veda-Anomap/Edgedevice_stm32/VERSION_HISTORY.md

# Version History

프로젝트 변경 이력을 시간 순서대로 기록합니다.
각 항목은 아래 형식으로 정리합니다.

- 변경 전 문제
- 변경 이유
- 구현 방식
- 변경 후 효과

---

## [v1.2.14] - 2026-03-25
### TDOA 9단계: FFT/IFFT 기반 GCC-PHAT 전환 + 게이트 경로 분리

변경 전 상태/문제
- TDOA Stage-3 경로가 128-point 직접 DFT + lag별 상관 직접합산(`O(N^2)`) 구조라, 연산량이 크고 주기 부하가 높았음.
- I2S 입력에서 하드 노이즈 게이트(`|x|<TH => 0`)를 TDOA 입력에도 동일 적용해, 위상 기반 상관에서 불연속 아티팩트가 생길 여지가 있었음.

왜 바꿨는지
- TDOA 추정의 핵심 연산을 더 가볍고 안정적인 주파수 도메인 파이프라인으로 바꿔 실시간 여유를 확보하기 위함.
- 레벨 기반 방향검출(`detect_dir`)에 필요한 게이트는 유지하되, GCC-PHAT 위상 경로는 원 신호를 보존해 피크 왜곡을 줄이기 위함.

무엇을 어떻게 바꿨는지
- `Core/Src/mic.c`
  - 직접 DFT/lag합산 함수를 제거하고, `radix-2 FFT/IFFT (128)` 기반 함수 추가:
    - `tdoa_fft_c128_inplace()`
    - `tdoa_fft_real_windowed_128()`
    - `tdoa_ifft_phat_to_corr_abs()`
  - Stage-3 계산 흐름 변경:
    - `FFT(X1), FFT(X2)` -> `G = X1*conj(X2)` -> `PHAT normalize` -> `IFFT` -> lag 구간 피크 탐색
  - I2S 샘플 처리 경로 분리:
    - `l16/r16`(게이트 적용) -> 기존 레벨/방향검출 경로(`mic_process_interleaved_u16`)
    - `l16_tdoa/r16_tdoa`(ungated) -> TDOA half-block 누적 버퍼
  - TDOA 버퍼 저장값은 ungated 샘플 사용하도록 변경.
- `README.md`
  - TDOA 9단계(FFT/IFFT 전환 + 게이트 분리) 반영.
  - TDOA 동작 주의사항에 `O(N log N)` 전환/게이트 분리 정책 추가.

변경 후 기능/안정성 개선 효과
- TDOA 핵심 연산 복잡도가 `O(N^2)`에서 `O(N log N)`로 낮아져 주기 부하가 완화됨.
- 위상 경로 신호 보존으로 GCC-PHAT 피크 품질 저하 가능성이 줄어듦.
- `detect_dir` 경로의 노이즈 억제 특성은 유지하면서 TDOA 추정 신뢰도 개선 여지 확보.

영향 파일
- `Core/Src/mic.c`
- `README.md`
- `VERSION_HISTORY.md`

---

## [v1.2.13] - 2026-03-20
### TDOA 8단계: 연산 주기 제한 + 모드 기반 스케줄링 최적화

변경 전 상태/문제
- TDOA(GCC-PHAT) 경로가 ControlTask 주기마다 실행되어, AUTO/수동 여부와 관계없이 CPU를 지속 점유했음.
- 수동 제어 중에도 불필요한 TDOA 연산이 돌아 UART/명령 응답성에 부담을 줄 수 있었음.
- TDOA 결과가 오래 갱신되지 않아도 `valid` 상태가 잠시 남을 수 있었음.

왜 바꿨는지
- 실시간 제어에서 “필요할 때만 무거운 연산을 수행”하도록 스케줄링을 최적화해 전체 시스템 여유를 확보하기 위함.
- MANUAL 우선 구간에서는 입력/제어 응답성을 높이고, AUTO에서는 안정된 주기로 TDOA를 유지하기 위함.

무엇을 어떻게 바꿨는지
- `Core/Src/mic.c`
  - TDOA 주기 제한 상수 추가:
    - `TDOA_PROCESS_PERIOD_MS=20`
    - `TDOA_STALE_INVALID_MS=300`
  - 런타임 상태 추가:
    - `tdoa_last_proc_ms`, `tdoa_last_result_ms`
  - `mic_tdoa_process(now)`에서 20ms 미만 호출은 heavy 연산을 스킵하도록 변경.
  - 결과 갱신이 오래 없으면 `valid`를 자동 해제(stale invalidate).
  - `mic_tdoa_enable(0)` 시 관련 타임스탬프/상태 초기화.
- `Core/Src/app.c`
  - `app_control_loop()`에서 TDOA 처리를 `MODE_AUTO`일 때만 호출하도록 변경.

변경 후 기능/안정성 개선 효과
- ControlTask의 평균 CPU 점유 감소(특히 MANUAL 모드).
- 수동 조작/통신 처리 응답성 개선.
- 오래된 TDOA 결과의 잔존으로 인한 잘못된 신뢰 상태가 줄어듦.

영향 파일
- `Core/Src/mic.c`
- `Core/Src/app.c`
- `README.md`
- `VERSION_HISTORY.md`

---

## [v1.2.12] - 2026-03-20
### TDOA 7단계: 물리 lag 제한 + Hann 윈도우 적용

변경 전 상태/문제
- GCC-PHAT lag 탐색이 고정 범위(`±8`)라 실제 마이크 간격(120mm)에서 물리적으로 불가능한 지연까지 후보에 포함되어,
  반향/잡음 상황에서 가짜 피크를 선택할 여지가 있었음.
- 프레임 경계 불연속으로 인한 스펙트럼 누설이 피크 선명도를 떨어뜨릴 수 있었음.

왜 바꿨는지
- TDOA 추정을 실제 하드웨어 기하(마이크 간격, 음속, 샘플레이트)에 맞춘 유효 범위로 제한해 오탐을 줄이기 위함.
- PHAT 이전 스펙트럼 안정화를 통해 피크 분리를 개선하기 위함.

무엇을 어떻게 바꿨는지
- `Core/Src/mic.c`
  - `tdoa_effective_lag_max()` 추가:
    - `lag_max = round(fs*d/c) + margin` 계산 후 `TDOA_LAG_MAX`로 clamp
    - lag 스캔/보간 경계를 동적으로 `±lag_max`로 사용
  - Hann window 추가:
    - `tdoa_prepare_hann()`로 128프레임 윈도우 1회 생성
    - `tdoa_dft_real_128()`에 window 인자 추가 후 DFT 입력에 적용
  - 리셋 시 Hann 준비 상태 초기화
- `Core/Src/app.c`
  - UART1 복구 함수 내 깨진 주석 정리(동작 변경 없음)

변경 후 기능/안정성 개선 효과
- 물리적으로 불가능한 lag 후보가 제거되어 반향 환경의 잘못된 방향 선택 확률 감소.
- 윈도우 적용으로 스펙트럼 누설이 줄어 피크 대조도가 개선되고 confidence 변동 완화.
- 기존 Stage 4~6(히스테리시스/EMA/추종기)와 결합 시 방향 추종 안정성 추가 향상.

영향 파일
- `Core/Src/mic.c`
- `Core/Src/app.c`
- `VERSION_HISTORY.md`

---

## [v1.2.11] - 2026-03-20
### TDOA 6단계: PAN 추종기 가변 이득 + 가속도 제한

변경 전 상태/문제
- 5단계는 TDOA 각도 연동은 되었지만, PAN 추종 step이 사실상 고정에 가까워
  큰 오차 구간에서 느리고, 목표 근처에서는 미세 떨림 체감이 남을 수 있었음.
- 추종 속도 상태가 없어 프레임 간 오차 변화에 따른 자연스러운 가감속이 부족했음.

왜 바꿨는지
- 실제 팬틸트 동작에서 “멀 때 빠르게 / 가까우면 부드럽게” 동작하도록
  추종 프로파일을 제어기 형태로 개선하기 위함.

무엇을 어떻게 바꿨는지
- `Core/Src/motor_ctrl.c`
  - TDOA 추종 파라미터 추가:
    - `TDOA_STEP_MIN/MAX_PWM`
    - `TDOA_GAIN_Q8`
    - `TDOA_ACCEL_UP/DN_PWM`
    - `TDOA_DEADBAND_PWM`
  - 내부 속도 상태(`tdoa_track_speed_pwm`) 도입
  - `motor_ctrl_track_pan_tdoa()`를 가변 이득 + 가속도 제한 방식으로 변경:
    - 오차 기반 목표 step 계산
    - step 변화율 제한(accel/decel limit)
    - 목표점 근처 overshoot 방지(목표 교차 시 클램프)
  - 모드 전환/기존 detect_dir 제어 진입 시 추종 속도 상태 초기화

변경 후 기능/안정성 개선 효과
- 큰 각도 오차에서 추종 응답 속도 향상.
- 목표 근처에서 속도가 줄어 급한 튐/잔떨림 완화.
- AUTO fallback 경로(`SRC:D`)와 공존하면서 제어 전환 충격 감소.

영향 파일
- `Core/Src/motor_ctrl.c`
- `VERSION_HISTORY.md`

---

## [v1.2.10] - 2026-03-20
### TDOA 5단계: 각도 기반 PAN 추종 + 자동 fallback 연계

변경 전 상태/문제
- 4단계까지는 TDOA 각도 신호 품질을 안정화했지만, 실제 AUTO 모터 제어는 여전히 `L/R` 2값 중심으로 동작했음.
- TDOA `valid`가 존재해도 모터가 각도 연속 추종을 하지 않아, 세밀한 방향 제어 이점이 제한적이었음.

왜 바꿨는지
- TDOA 파이프라인 결과(`alpha_deg_x10`)를 실제 PAN 제어에 연결해
  좌/우 이진 제어에서 연속 각도 추종으로 확장하기 위함.
- TDOA 신호가 잠시 사라질 때는 기존 `detect_dir` 로직으로 자동 복귀해 안정성을 유지하기 위함.

무엇을 어떻게 바꿨는지
- `Core/Inc/motor_ctrl.h`
  - `motor_ctrl_track_pan_tdoa()` API 추가
- `Core/Src/motor_ctrl.c`
  - TDOA 각도(-90~+90도)를 PAN PWM 범위로 매핑하는 함수 추가
  - PAN 추종 시 step 제한(`TDOA_STEP_PWM`) + deadband(`TDOA_DEADBAND_PWM`) 적용
  - TDOA 추종 활성 중 기존 one-shot auto state(`pending_dir/motor_running/lock`) 비활성화
- `Core/Src/app.c`
  - AUTO 루프에서 TDOA 우선 제어 경로 추가:
    - `valid`면 TDOA 각도 추종
    - `valid` 소실 시 짧은 hold(`TDOA_FALLBACK_HOLD_MS`) 후 기존 `mic_process()+motor_ctrl_process()`로 fallback
  - 디버그 로그에 제어 소스 표기 `SRC:T/D/M` 추가

변경 후 기능/안정성 개선 효과
- AUTO 모드에서 TDOA 유효 시 PAN이 연속 각도 기반으로 부드럽게 추종.
- TDOA 신호 공백 시 기존 L/R 로직으로 자동 복귀해 동작 연속성 확보.
- 로그로 현재 제어 소스(`SRC`)를 즉시 확인 가능해 현장 디버깅 용이성 증가.

영향 파일
- `Core/Inc/motor_ctrl.h`
- `Core/Src/motor_ctrl.c`
- `Core/Src/app.c`
- `VERSION_HISTORY.md`

---

## [v1.2.9] - 2026-03-20
### TDOA 4단계: 히스테리시스 + hold + EMA + slew 제한

변경 전 상태/문제
- 3단계에서 `tau/angle` 계산은 가능해졌지만, 반향/잡음 환경에서 confidence가 경계값 근처를 오갈 때
  `valid`가 빠르게 깜빡이며 각도도 프레임 단위로 흔들릴 수 있었음.
- 모터 추종 전에 각도 신호를 한 번 더 안정화하지 않으면 미세 진동/방향 반전 체감이 커질 수 있었음.

왜 바꿨는지
- 실시간 운용에서 “신뢰도 경계 출렁임”을 줄이고, 연속 프레임의 각도 변화를 부드럽게 만들어
  제어 입력으로 쓰기 좋은 형태로 다듬기 위함.

무엇을 어떻게 바꿨는지
- `Core/Src/mic.c`
  - confidence 히스테리시스 추가:
    - ON 임계(`TDOA_CONF_ON_Q8`)
    - OFF 임계(`TDOA_CONF_OFF_Q8`)
  - 유효 신호 hold 시간(`TDOA_VALID_HOLD_MS`) 추가:
    - 순간적인 confidence 하락에도 짧은 구간은 `valid` 유지
  - 각도 안정화 필터 추가:
    - 프레임 간 최대 변화량 제한(`TDOA_MAX_STEP_DEG_X10`)
    - EMA(`TDOA_EMA_ALPHA_Q8`) 적용
    - 각도 clamp(`TDOA_ANGLE_CLAMP_DEG_X10`) 적용
  - 내부 상태 변수(`tdoa_track_valid`, `tdoa_last_good_ms`, `tdoa_ema_angle_x10`) 추가

변경 후 기능/안정성 개선 효과
- confidence 경계 구간에서 `valid` 깜빡임이 줄어듦.
- 각도 변화가 단계적으로 완만해져 추종 신호 품질 향상.
- 이후 모터 제어 연결 단계에서 진동/급반전 리스크 감소.

영향 파일
- `Core/Src/mic.c`
- `VERSION_HISTORY.md`

---

## [v1.2.8] - 2026-03-20
### TDOA 3단계: 경량 GCC-PHAT + 서브샘플 보간 + 각도 산출

변경 전 상태/문제
- 2단계는 VAD/오버랩/코스 lag까지만 있어, lag가 샘플 단위로만 나오고 미세 각도 분해능이 낮았음.
- 반향 환경에서 단순 상관만으로는 피크 분리가 약해 신뢰도 변동이 컸음.

왜 바꿨는지
- 1D 좌우 각도 제어를 목표로, TDOA를 샘플 정수 단위에서 서브샘플 단위로 정밀화하기 위함.
- PHAT 정규화를 적용해 반향/진폭 영향에 덜 민감한 지연 추정을 확보하기 위함.

무엇을 어떻게 바꿨는지
- `Core/Src/mic.c`
  - `mic_tdoa_process()`를 Stage-3 파이프라인으로 교체:
    - 128프레임 DFT(양 채널) 계산
    - cross-power PHAT 정규화
    - 제한 lag 범위(`-L..+L`) 상관 탐색
    - 3점 포물선 보간으로 서브샘플 오프셋 `p` 추정
    - `tau_us`, `alpha_deg_x10` 계산(마이크 간격/음속 기반)
  - NaN/비정상 각도 시 coarse angle fallback 유지
  - 기존 VAD/confidence 게이트는 그대로 유지
- `Core/Src/app.c`
  - AUTO 로그에 TDOA 상세값 확장:
    - `V`(valid), `L`(정수 lag), `T`(tau_us), `A`(deg), `C`(confidence)

변경 후 기능/안정성 개선 효과
- 샘플 경계 양자화 오차가 완화되어 각도 변동이 더 부드럽게 관측됨.
- PHAT 정규화로 진폭 편차/반향 환경에서 lag 피크 분리 안정성 개선.
- 기존 모터 제어 경로는 유지되어 단계적 검증이 가능.

영향 파일
- `Core/Src/mic.c`
- `Core/Src/app.c`
- `VERSION_HISTORY.md`

---

## [v1.2.7] - 2026-03-20
### TDOA 2단계: VAD + 50% 오버랩 프레임 + 코스 lag 추정

변경 전 상태/문제
- 1단계에서는 TDOA API/디버그 구조만 존재하고, 실제 프레임 전처리(VAD/오버랩)가 없어
  짧은 이벤트(박수/클랩)가 프레임 경계에 걸릴 때 누락 가능성이 있었음.
- 무의미한 저에너지 구간에도 동일 처리 경로를 타기 때문에 이후 단계 연산 확장 시 비효율 우려가 있었음.

왜 바꿨는지
- 3단계(GCC-PHAT) 전에, 실시간 입력을 안정적으로 프레임화하고
  “유효한 소리 구간만 통과시키는” 전처리 체인을 먼저 고정하기 위함.

무엇을 어떻게 바꿨는지
- `Core/Src/mic.c`
  - TDOA 전처리 매크로/버퍼 추가:
    - half block 64샘플, overlap frame 128샘플(50% 오버랩)
    - `TDOA_VAD_MEANABS_TH`, `TDOA_LAG_MAX` 등 stage-2 상수 추가
  - I2S 콜백에서 clean sample을 64샘플 블록으로 축적 후 `ready` 시퀀스 갱신.
  - `mic_tdoa_process()`에서:
    - 최신 half block 수신 여부 확인
    - 이전 half + 현재 half 결합으로 128 프레임 구성
    - mean-abs 기반 VAD 적용
    - 짧은 lag 범위 상관으로 코스 `lag/tau/confidence` 산출
    - confidence 게이트(`TDOA_CONF_TH_Q8`)로 `valid` 설정
- `Core/Src/app.c`
  - `app_init()`에서 `mic_tdoa_enable(1)` 활성화
  - `app_control_loop()`에서 `mic_tdoa_process(now)` 주기 호출
  - AUTO 로그에 `TDOA[V/L/C]` 필드 추가

변경 후 기능/안정성 개선 효과
- 프레임 경계 누락이 줄어들고, 저에너지 구간은 VAD로 빠르게 걸러짐.
- 아직 GCC-PHAT 전이지만, 입력 품질과 lag 안정성을 로그로 선검증 가능.
- 기존 방향 제어(`detect_dir`) 경로는 유지되어 회귀 리스크를 낮춤.

영향 파일
- `Core/Src/mic.c`
- `Core/Src/app.c`
- `VERSION_HISTORY.md`

---

## [v1.2.6] - 2026-03-20
### TDOA 1단계 스켈레톤 API/디버그 경로 추가

변경 전 상태/문제
- TDOA 기능을 단계적으로 붙이려 해도, `mic` 모듈에 TDOA용 공용 API와 디버그 컨테이너가 없어
  이후 단계(VAD/GCC-PHAT/각도 추정)를 안전하게 분리 적용하기 어려웠음.
- 앱 레이어에서 “TDOA 활성/상태 조회”를 호출할 수 있는 최소 인터페이스가 부재했음.

왜 바꿨는지
- 1단계에서는 동작 변경 없이 인터페이스만 먼저 고정해서,
  다음 단계 구현 시 회귀 범위를 줄이고 빌드 안정성을 확보하기 위함.

무엇을 어떻게 바꿨는지
- `Core/Inc/mic.h`
  - `mic_tdoa_debug_t` 구조체 추가.
  - TDOA API 선언 추가:
    - `mic_tdoa_enable()`
    - `mic_tdoa_process()`
    - `mic_tdoa_is_valid()`
    - `mic_get_tdoa_debug()`
- `Core/Src/mic.c`
  - 위 API의 1단계 스텁 구현 추가.
  - `tdoa_enabled`, `tdoa_dbg` 런타임 상태 추가.
  - 현재는 `peak_main/peak_second/confidence/vad_pass`만 placeholder로 갱신하고,
    `lag/tau/angle/valid`는 고정(미추정)으로 유지.

변경 후 기능/안정성 개선 효과
- 코드가 아직 GCC-PHAT/TDOA 계산을 하지 않아 기존 좌/우 제어 동작에는 영향 없음.
- 이후 단계 구현 시 `mic` API 변경 없이 내부만 확장 가능해 통합 리스크 감소.

영향 파일
- `Core/Inc/mic.h`
- `Core/Src/mic.c`
- `VERSION_HISTORY.md`

---

## [v1.2.5] - 2026-03-20
### 워치독 로직 파일 분리(rpi_watchdog / sys_watchdog)

변경 전 상태/문제
- 외부 릴레이 워치독과 내부 IWDG 감시 로직이 `main.c`에 함께 있어
  파일 크기가 커지고 수정 영향 범위 파악이 어려웠음.
- 워치독 정책 변경 시 `main.c`의 생성 코드와 사용자 코드 경계가 복잡해 유지보수성이 떨어졌음.

왜 바꿨는지
- 외부 워치독(PC3/PC10)과 내부 워치독(IWDG refresh) 책임을 분리해
  디버깅/테스트/정책 변경을 독립적으로 수행하기 위함.

무엇을 어떻게 바꿨는지
- 신규 파일 추가:
  - `Core/Src/rpi_watchdog.c`, `Core/Inc/rpi_watchdog.h`
  - `Core/Src/sys_watchdog.c`, `Core/Inc/sys_watchdog.h`
- 외부 워치독 기능 이동:
  - heartbeat 감시, hb arm 정책, 릴레이 컷/복구, UART2 로그
  - 부팅 reset-cause/IWDG 설정 로그 출력
- 내부 IWDG 기능 이동:
  - alive counter 모니터링, miss 정책, `HAL_IWDG_Refresh` 수행/중단
- `main.c`는 초기화 및 태스크 래퍼만 유지:
  - `StartDefaultTask -> rpi_watchdog_task`
  - `StartSystemMonitorTask -> sys_watchdog_task`

변경 후 기능/안정성 개선 효과
- 워치독 관련 코드 가독성/응집도 향상.
- 외부/내부 워치독 단독 테스트가 쉬워져 장애 원인 분리 속도 개선.
- `main.c` 복잡도 감소로 CubeMX 재생성 시 충돌 위험 완화.

영향 파일
- `Core/Src/main.c`
- `Core/Src/rpi_watchdog.c` (신규)
- `Core/Inc/rpi_watchdog.h` (신규)
- `Core/Src/sys_watchdog.c` (신규)
- `Core/Inc/sys_watchdog.h` (신규)
- `VERSION_HISTORY.md`

---

## [v1.2.4] - 2026-03-20
### 첫 Heartbeat 수신 전 timeout 비활성(오탐 릴레이 컷 방지)

변경 전 상태/문제
- 워치독은 grace 이후 heartbeat timeout 감시를 바로 시작했기 때문에,
  RPi heartbeat 토글 프로그램을 수동으로 늦게 실행하면 첫 heartbeat를 받기 전에
  timeout으로 릴레이가 동작할 수 있었음.

왜 바꿨는지
- 요구 동작이 “1/0이 오다가 끊길 때만 워치독 동작”이므로,
  최초 heartbeat 이전에는 감시를 arm하지 않는 게 맞음.

무엇을 어떻게 바꿨는지
- `StartDefaultTask`에 `hb_armed` 상태 추가.
- 초기/복구 직후에는 `hb_armed=0`으로 두고 timeout 판단 비활성.
- 첫 엣지 감지 시 `hb_armed=1`로 전환하여 이후부터만 timeout 릴레이 컷 수행.
- UART2 로그로 `waiting first edge` / `watchdog armed` 상태를 출력.

변경 후 기능/안정성 개선 효과
- heartbeat 미시작 상태에서 오탐 릴레이 컷 제거.
- 실제 heartbeat가 살아있다가 끊길 때만 워치독 동작.

영향 파일
- `Core/Src/main.c`
- `VERSION_HISTORY.md`

---

## [v1.2.3] - 2026-03-20
### 워치독 태스크 스택 증설(512B -> 1536B)로 부팅 직후 리셋 반복 완화

변경 전 상태/문제
- UART2에 `[RST]`, `[IWDG]`까지만 찍히고 이후 로그가 끊기거나,
  `[RPI-WDG] st`처럼 로그가 중간에서 잘린 채 재부팅되는 현상이 반복됨.
- 리셋 원인 로그에서 `IWDG:1`이 계속 찍혀, 태스크가 정상 루프에 진입하기 전에
  IWDG 갱신이 끊기는 패턴이 관측됨.

왜 바꿨는지
- `defaultTask`는 워치독 대기/토글 감시뿐 아니라 UART 포맷 로그(`vsnprintf`)와
  `HAL_UART_Transmit` 호출 경로를 사용함.
- 기존 `defaultTask` 스택이 `128*4 = 512B`로 작아, 포맷 문자열 처리/함수 호출 프레임이 겹치면
  스택 마진이 부족해질 수 있음.
- 스택 손상(또는 태스크 비정상 동작) 시 `SystemMonitorTask`가 IWDG refresh를 지속하지 못해
  하드웨어 리셋으로 이어질 수 있으므로, 우선 스택 여유 확보가 필요했음.

무엇을 어떻게 바꿨는지
- `defaultTask` 스택 크기를 `128*4`에서 `384*4`로 증설.
  - 변경 전: 512B
  - 변경 후: 1536B
- 코드 위치:
  - `Core/Src/main.c` `defaultTask_attributes.stack_size`

변경 후 기능/안정성 개선 효과
- 부팅 직후 워치독 로그 출력 구간에서 태스크 스택 여유가 늘어나
  로그 중간 절단/즉시 재부팅 가능성 완화.
- 워치독 루프 진입 전후 구간 안정성이 개선되어 원인 분리(IWDG vs 전원강하) 진단이 쉬워짐.

영향 파일
- `Core/Src/main.c`
- `VERSION_HISTORY.md`

---

## [v1.2.2] - 2026-03-20
### STM 반복 리셋 원인 추적 로깅 + IWDG 갱신 스케줄링 보강

변경 전 상태/문제
- STM이 반복 리셋될 때, 원인이 IWDG인지 BOR(전원 강하)인지 부팅 로그만으로 구분하기 어려웠음.
- `SystemMonitorTask`가 `Low` 우선순위라 UART burst/다른 태스크 부하 상황에서 IWDG 갱신 타이밍이 밀릴 여지가 있었음.

왜 바꿨는지
- 리셋 원인을 즉시 분류해 하드웨어 전원 문제와 소프트웨어 스케줄링 문제를 빠르게 분리하기 위함.
- IWDG refresh 태스크의 실행 우선권을 높여 불필요한 watchdog 리셋 가능성을 줄이기 위함.

무엇을 어떻게 바꿨는지
- 부팅 직후 UART2로 reset cause 플래그를 출력하도록 추가:
  - `BOR/PIN/POR/SW/IWDG/WWDG/LPWR`
- 출력 후 `__HAL_RCC_CLEAR_RESET_FLAGS()`로 플래그 클리어.
- IWDG 설정값 출력 로그 추가(`presc`, `reload`, `miss_max`).
- 태스크 우선순위 조정:
  - `SystemMonitorTask`: `Low -> AboveNormal`
  - `UartRxTask`: `AboveNormal -> Normal`

변경 후 기능/안정성 개선 효과
- 리셋 발생 시 원인 판별 속도 향상(IWDG 리셋 vs 전원 이슈).
- UART 입력 부하가 있어도 IWDG 갱신 태스크가 덜 밀려 안정성 향상.

영향 파일
- `Core/Src/main.c`
- `VERSION_HISTORY.md`

---

## [v1.2.1] - 2026-03-20
### 외부/내부 워치독 최종 튜닝 + 큐 복구 반영

변경 전 상태/문제
- 워치독 로직은 동작했지만, IWDG 타임아웃(약 5초) 대비 모니터 miss 임계가 보수적으로 작아
  스케줄링 지터 상황에서 불필요한 리셋 가능성이 있었음.
- `.ioc` 재생성 과정에서 `control_queue` 길이가 `64 -> 16`으로 내려가 버려 burst 구간 내성이 약해질 수 있었음.
- 문서에 최신 워치독 파라미터(10초/3초/60초, miss 임계)가 명시되지 않았음.

왜 바꿨는지
- 외부 릴레이 복구 로직과 내부 IWDG 리셋 정책을 실제 운용 지터까지 고려해 안정적으로 맞추기 위함.
- RPi 명령 burst 상황에서 명령 유실/ACK fail 가능성을 낮추기 위함.

무엇을 어떻게 바꿨는지
- `SYS_MONITOR_MISS_MAX`를 `4`로 조정(1초 주기 기준, 4회 연속 미갱신 시 refresh 중단).
- `StartDefaultTask`의 grace/relay 대기 구간을 공통 helper 함수로 정리:
  - `rpi_wdg_wait_seconds_and_mark_alive()`
  - `rpi_wdg_sync_heartbeat_baseline()`
- `control_queue`를 코드/IOC 모두 `64`로 복구.
- README에 watchdog 정책과 큐 길이 정보를 최신 코드 기준으로 업데이트.

변경 후 기능/안정성 개선 효과
- 워치독 오탐 리셋 여유가 증가해 장시간 운용 안정성이 개선됨.
- 릴레이 컷/복구/재-grace 흐름의 코드 가독성과 유지보수성이 향상됨.
- burst 명령 수용성이 이전 수준으로 복구됨.

영향 파일
- `Core/Src/main.c`
- `irrled.ioc`
- `README.md`

---

## [v1.1.4] - 2026-03-19
### 수동 모터 명령 버스트 완화 + 서보 안전 범위 축소

변경 전 상태/문제
- 수동 명령(`w/a/s/d`)이 짧은 시간에 몰리면 queue의 모든 명령이 연속 적용되어 서보가 과격하게 움직일 수 있었음.
- 기계적 종단 근처에서 급격한 왕복/충돌 느낌이 발생할 수 있었음.

왜 바꿨는지
- 실제 하드웨어에서 “획 도는 현상”과 극단 위치 떨림을 줄이기 위해, 제어를 부드럽게 제한할 필요가 있었음.

무엇을 어떻게 바꿨는지
- 수동 이동 명령을 coalescing 처리(최신 1개만 유지)하도록 `app.c`에 반영.
- `MANUAL_CMD_MIN_INTERVAL_MS`를 두어 최소 적용 간격을 강제.
- PAN/TILT PWM 한계를 기존보다 안쪽으로 조정(`motor_ctrl.h`)해 기계적 여유를 확보.

변경 후 기능/안정성 개선 효과
- 입력 버스트 시 서보가 한 번에 몰아 움직이는 현상이 완화됨.
- 종단 충돌 가능성 감소, 체감 안정성 증가.

영향 파일
- `Core/Src/app.c`
- `Core/Inc/motor_ctrl.h`

---

## [v1.1.3] - 2026-03-18
### UART1 파서 강건화(프레임 경계/타임아웃/큐)

변경 전 상태/문제
- UART1으로 데이터가 연속 유입될 때 프레임 경계가 흐트러지면, 잘못된 CMD/LEN을 기반으로 파서가 오동작할 수 있었음.
- 프레임 조립 도중 바이트 유입이 끊기면 상태머신이 중간 상태에 머물러 다음 정상 프레임까지 연쇄 실패가 발생할 수 있었음.
- 단일 완료 버퍼 구조에서는 burst 구간에서 뒤늦게 들어온 정상 프레임이 유실될 여지가 있었음.

왜 바꿨는지
- 라즈베리파이 연동 시 간헐적으로 발생하던 응답 실패를 줄이고, 프레임 손상 후 자동 복구 시간을 짧게 만들기 위해서.

무엇을 어떻게 바꿨는지
- CMD allow-list(`0x04`, `0x05`)를 적용해 유효하지 않은 타입은 즉시 폐기하도록 변경.
- `PROTO_RX_TIMEOUT_MS` 기준 타임아웃 리셋을 넣어 조립 중단 프레임이 다음 프레임에 영향 주지 않도록 분리.
- 완료 프레임 큐를 다중 슬롯 구조로 바꿔 burst 입력에서도 처리 여유를 확보.
- 바이트 조립 단계와 프레임 처리 단계를 분리해 디버깅과 장애 원인 추적이 가능하도록 정리.

변경 후 기능/안정성 개선 효과
- 입력 품질이 일시적으로 나빠져도 파서가 빠르게 정상 상태로 복귀.
- burst 구간 프레임 유실 가능성 감소.
- 통신 실패 원인(입력 손상/포맷 오류/처리 지연) 분리가 쉬워짐.

영향 파일
- `Core/Src/app.c`
- `Core/Src/main.c`

---

## [v1.1.2] - 2026-03-18
### UART1 진단 카운터 확장 및 운영 분석 기준 추가

변경 전 상태/문제
- 통신 실패가 발생해도 원인이 하드웨어인지 프로토콜인지 즉시 구분하기 어려웠음.

왜 바꿨는지
- 현장 디버깅 시간을 줄이려면 에러 유형별 계측값이 필요했음.

무엇을 어떻게 바꿨는지
- UART1 진단 카운터를 세분화:
- 하드웨어 계층: `O/F/N/P`
- 프로토콜 계층: `IV/OV`
- 복구 계층: `R/RO/RF`
- 런타임 로그에 위 카운터를 포함해 관찰 가능하도록 정리.

변경 후 기능/안정성 개선 효과
- “라인 품질 문제”와 “프레임 포맷 문제”를 빠르게 분리 가능.
- 장애 재현 시 원인 축소 시간이 단축됨.

영향 파일
- `Core/Src/app.c`
- `VERSION_HISTORY.md`

---

## [v1.1.1] - 2026-03-18
### UART1 에러 복구 루틴 추가

변경 전 상태/문제
- FE/NE/PE/OE 등의 UART 오류가 한 번 발생하면 RX 인터럽트 재암이 실패하는 경우가 있었고,
  이 상태가 누적되면 UART1 수신이 장시간 멈출 수 있었음.

왜 바꿨는지
- 통신 라인 노이즈나 순간 타이밍 오류가 시스템 전체 통신 중단으로 번지지 않도록 복구 경로를 강제하기 위해.

무엇을 어떻게 바꿨는지
- 오류 발생 시 플래그 클리어 -> `HAL_UART_Receive_IT` 재암 순서로 기본 복구.
- 재암 실패 시 abort 후 재시도 루틴을 추가해 하드락 상태를 피하도록 처리.
- 복구 횟수 카운터를 남겨 런타임 상태에서 복구 성공/실패 추세를 추적 가능하게 구성.

변경 후 기능/안정성 개선 효과
- 일시적 UART 오류 후 자동 복구 확률이 크게 증가.
- 통신 중단 상태가 길게 지속될 위험 감소.

영향 파일
- `Core/Src/app.c`

---

## [v1.1.0] - 2026-03-18
### README/HISTORY 문서 구조 정리

변경 전 상태/문제
- 코드가 빠르게 변경되면서 README/HISTORY의 일부 설명이 실제 실행 경로와 달라짐.
- 신규 작업 시 과거 변경 맥락을 다시 코드에서 역추적해야 해서 디버깅 착수 시간이 길어졌음.

왜 바꿨는지
- 문서만으로 현재 구조와 의사결정 배경을 빠르게 파악할 수 있어야 기능 추가/장애 대응 속도가 올라가기 때문.

무엇을 어떻게 바꿨는지
- README를 현재 RTOS 태스크 구조, UART 프로토콜, 센서/모터 흐름 기준으로 재정렬.
- VERSION_HISTORY를 `변경 전 상태/문제 -> 왜 바꿨는지 -> 무엇을 어떻게 바꿨는지 -> 변경 후 효과` 형식으로 통일.

변경 후 기능/안정성 개선 효과
- 작업 히스토리의 추적성이 올라가 회귀 분석 시간이 단축됨.
- 코드-문서 불일치로 인한 설정/동작 오해 감소.

영향 파일
- `README.md`
- `VERSION_HISTORY.md`

---

## [v1.0.0] - 2026-03-18
### 마이크 경로 ADC -> I2S 전환 및 신호 안정화 반영

변경 전 상태/문제
- ADC 기반 설계와 I2S 전환 코드가 혼재되어 기준점/스케일/노이즈 처리가 불명확했음.

왜 바꿨는지
- INMP441(I2S) 기반으로 방향 감지 성능을 유지하면서 기존 제어 로직과 호환해야 했음.

무엇을 어떻게 바꿨는지
- I2S 데이터 언팩(24-bit signed) 후 기존 처리 경로로 연결.
- 동적 DC 오프셋 추적(DC blocking), 노이즈 게이트 적용.
- short/long window 기반 신호/노이즈 분리 및 SNR/비율 게이트 유지.
- ADC 경로는 조건부 컴파일 fallback으로 유지.

변경 후 기능/안정성 개선 효과
- I2S 환경에서 기준점 흔들림과 저레벨 노이즈 오탐이 감소.
- 기존 모터 제어 로직을 크게 깨지 않고 이식 가능해짐.

영향 파일
- `Core/Src/mic.c`
- `Core/Inc/mic.h`
- `Core/Src/app.c`
- `Core/Src/main.c`
- `irrled.ioc`

---

## [v0.9.6] - 2026-03-10
### PCF8591 조도 센서 추가

변경 전 상태/문제
- 상태 응답이 온도/습도/방향 중심이라 주변 광량 정보가 비어 있었고,
  상위 시스템에서 환경 변화 판단 시 추가 채널이 필요했음.

왜 바꿨는지
- 단일 상태 요청에서 조도까지 함께 수집해 상위 제어 로직의 입력을 확장하기 위해.

무엇을 어떻게 바꿨는지
- I2C1 버스에 PCF8591(CH0) 읽기 모듈(`pcf8591.c/.h`) 추가.
- 센서 루프에서 조도 샘플을 읽어 앱 상태에 반영.
- 상태 응답 JSON에 `light` 필드를 추가해 RPi가 즉시 소비 가능하도록 구성.

변경 후 기능/안정성 개선 효과
- 상태 프레임 1회로 온습도/방향/조도 동시 조회 가능.
- 조도 기반 상위 로직 확장(임계치 감시/알림) 준비 완료.

영향 파일
- `Core/Inc/pcf8591.h` (신규)
- `Core/Src/pcf8591.c` (신규)
- `Core/Src/app.c`

---

## [v0.9.5] - 2026-03-05
### RTOS 실행 경로 정리

변경 전 상태/문제
- `osKernelStart()` 이후 실제로 실행되지 않는 while 루프 경로가 남아 있어,
  코드만 보면 베어메탈 경로와 RTOS 경로가 동시에 동작하는 것처럼 보였음.

왜 바꿨는지
- 실행 경로를 태스크 중심으로 단일화해 유지보수 시 해석 오류를 줄이기 위해.

무엇을 어떻게 바꿨는지
- RTOS 시작 이후 경로 기준으로 메인 흐름을 정리하고, 비도달 코드 구간을 제거/주석 정리.
- 제어/센서/수신 처리가 각각 태스크에서 수행된다는 점을 문서/코드에 명시.

변경 후 기능/안정성 개선 효과
- 런타임 동작 경로가 명확해 디버깅 진입점 선택이 쉬워짐.
- “왜 app_loop가 안 돈다” 같은 혼동 이슈 감소.

영향 파일
- `Core/Src/main.c`

---

## [v0.9.4] - 2026-03-05
### ControlTask / SensorTask 분리

변경 전 상태/문제
- 모터 제어, 센서 읽기, 상태 출력이 한 루프에 묶여 있어 I2C 지연이나 출력 지연이 발생하면
  모터 제어 주기까지 같이 늦어지는 구조였음.

왜 바꿨는지
- 센서 지연이 제어 루프 응답성에 전파되지 않도록 태스크 책임을 분리하기 위해.

무엇을 어떻게 바꿨는지
- `app_control_loop()`와 `app_sensor_loop()`로 기능 분리.
- 제어 루프 10ms, 센서 루프 20ms로 주기 분배해 우선순위 기반 스케줄링 적용.

변경 후 기능/안정성 개선 효과
- 모터 응답성이 센서 지연에 덜 영향받음.
- 태스크별 부하 분석이 쉬워져 성능 튜닝 포인트가 명확해짐.

영향 파일
- `Core/Inc/app.h`
- `Core/Src/app.c`
- `Core/Src/main.c`

---

## [v0.9.3] - 2026-03-05
### UART ISR 최소화 + RxTask 활성화

변경 전 상태/문제
- UART ISR 안에서 파싱 상태머신까지 처리해 인터럽트 체류 시간이 길었고,
  입력 burst에서 다른 태스크 지연 및 프레임 드롭 가능성이 있었음.

왜 바꿨는지
- ISR은 최소 동작만 수행하고, 파싱/비즈니스 로직은 태스크 컨텍스트에서 처리하는 RTOS 정석 구조로 바꾸기 위해.

무엇을 어떻게 바꿨는지
- ISR에서는 수신 바이트 1개를 `uart_rx_queue`에 넣고 즉시 리턴.
- `UartRxTask`에서 바이트 조립, 헤더/LEN/PAYLOAD 처리, 명령 분기 수행.

변경 후 기능/안정성 개선 효과
- 인터럽트 점유 시간 감소.
- burst 입력 상황에서도 전체 스케줄링 안정성 향상.
- 파싱 로직 테스트/수정 난이도 하락.

영향 파일
- `Core/Src/app.c`
- `Core/Src/main.c`

---

## [v0.9.2] - 2026-03-04
### 모터 명령 토큰 충돌 방지 정리

변경 전 상태/문제
- 단문 모드 토큰과 이동 토큰 해석 경계가 모호해,
  같은 문자라도 컨텍스트에 따라 다르게 해석될 여지가 있었음.

왜 바꿨는지
- RPi 프로토콜(JSON: `auto/unauto`, `w/a/s/d`)과 로컬 테스트 입력을 분리해 명령 충돌을 방지하기 위해.

무엇을 어떻게 바꿨는지
- 명령 allow-list를 명확히 정의하고 모드 전환 규칙을 정리.
- 자동/수동 모드에서 허용되는 입력을 분리해 예상치 못한 상태 전이 제거.

변경 후 기능/안정성 개선 효과
- 동일 입력에 대한 동작이 일관화됨.
- 모드 전환 직후 오동작 가능성 감소.

영향 파일
- `Core/Src/app.c`

---

## [v0.9.1] - 2026-03-03
### AHT10 상태머신 + 이동평균(N=10)

변경 전 상태/문제
- 센서 값을 너무 자주 읽거나 변환 대기 없이 읽으면 self-heating과 오측정이 발생할 수 있었음.
- 단발 스파이크 값이 그대로 상위 상태값에 반영되어, 연속 로그에서 값이 튀는 문제가 있었음.

왜 바꿨는지
- 실제 운용 환경에서 안정적인 온습도 값을 확보하려면 측정 주기 제한, 변환 완료 확인, 필터링이 함께 필요했음.

무엇을 어떻게 바꿨는지
- 측정 주기를 최소 1초 이상으로 강제하고 기본 주기를 2초로 설정.
- 측정 명령 전송 후 변환 대기(약 80ms)를 두고 BUSY 비트를 재확인하도록 상태머신 구성.
- 최근 N=10 샘플을 FIFO 이동평균으로 처리해 순간 튐 값을 완화.

변경 후 기능/안정성 개선 효과
- 과측정으로 인한 센서 자체 발열 영향 감소.
- 스파이크 완화로 시계열 안정성 향상.
- 상위 제어/표시 로직에서 값 활용 신뢰도 증가.

영향 파일
- `Core/Src/aht10.c`
- `Core/Inc/aht10.h`

---

## [v0.9.0] - 2026-03-02
### 프로젝트 분리 구조 정리(마이크/모터/앱 통합 제어)

변경 전 상태/문제
- 단일 파일에 기능이 몰려 구조 파악과 변경 영향 분석이 어려웠음.

왜 바꿨는지
- 기능별 책임을 분리해 유지보수성과 테스트 용이성을 높이기 위함.

무엇을 어떻게 바꿨는지
- `mic.c`, `motor_ctrl.c`, `app.c` 중심 구조로 역할 분리.
- `app.c`에서 상호 연계/모드 제어/프로토콜 처리 통합.

변경 후 기능/안정성 개선 효과
- 변경 범위 예측이 쉬워지고, 기능 추가 시 회귀 위험이 감소.

영향 파일
- `Core/Src/app.c`
- `Core/Src/mic.c`
- `Core/Src/motor_ctrl.c`
- `Core/Inc/*`

---

## 참고: 직접 테스트/분석 기반 개선 방향

- 인터럽트 최소화: ISR은 큐잉만, 파싱/응답은 태스크에서 처리.
- 태스크 분리: 제어 루프/센서 루프 분리로 지연 전파 차단.
- 프로토콜 안정화: CMD/LEN 검증, 프레임 타임아웃, 버스트 흡수.
- 진단 강화: UART 오류 카운터 분리로 원인 분석 속도 개선.
- 모터 안정화: burst coalescing + 최소 적용 간격 + 안전 범위 적용.
- 신호 안정화: I2S DC 블로킹/노이즈 게이트 + 윈도우 기반 SNR 게이트 유지.
