veda-Anomap/Edgedevice_stm32/Core/Src/main.c

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
/* Includes ------------------------------------------------------------------*/
#include "main.h"
#include "cmsis_os.h"

/* USER CODE BEGIN Includes */
#include "app.h"
#include "ir_led.h"
#include "rpi_watchdog.h"
#include "sys_watchdog.h"

/* USER CODE END Includes */

/* USER CODE BEGIN PD */
#define RPI_WDG_GRACE_SEC           60U
#define RPI_HEARTBEAT_TIMEOUT_MS 10000U
#define RPI_RELAY_CUT_SEC            3U
#define RPI_WDG_POLL_MS             10U

#define SYS_MONITOR_PERIOD_MS     1000U
/* With ~5s IWDG timeout, allow up to 3 missed checks and stop refresh on 4th miss */
#define SYS_MONITOR_MISS_MAX         4U
#define RPI_WDG_UART_LOG_ENABLE      0U

/* USER CODE END PD */

I2C_HandleTypeDef hi2c1;

I2S_HandleTypeDef hi2s2;
DMA_HandleTypeDef hdma_spi2_rx;

IWDG_HandleTypeDef hiwdg;

TIM_HandleTypeDef htim3;
TIM_HandleTypeDef htim11;

UART_HandleTypeDef huart1;
UART_HandleTypeDef huart2;

/* Definitions for defaultTask */
osThreadId_t defaultTaskHandle;
const osThreadAttr_t defaultTask_attributes = {
  .name = "defaultTask",
  /* Watchdog task uses UART log formatting path; keep enough stack margin */
  .stack_size = 384 * 4,
  .priority = (osPriority_t) osPriorityNormal,
};
/* Definitions for UartRxTask */
osThreadId_t UartRxTaskHandle;
const osThreadAttr_t UartRxTask_attributes = {
  .name = "UartRxTask",
  .stack_size = 512 * 4,
  .priority = (osPriority_t) osPriorityNormal,
};
/* Definitions for ControlTask */
osThreadId_t ControlTaskHandle;
const osThreadAttr_t ControlTask_attributes = {
  .name = "ControlTask",
  .stack_size = 384 * 4,
  .priority = (osPriority_t) osPriorityNormal,
};
/* Definitions for SensorTask */
osThreadId_t SensorTaskHandle;
const osThreadAttr_t SensorTask_attributes = {
  .name = "SensorTask",
  .stack_size = 384 * 4,
  .priority = (osPriority_t) osPriorityBelowNormal,
};
/* Definitions for uart_rx_queue */
osMessageQueueId_t uart_rx_queueHandle;
const osMessageQueueAttr_t uart_rx_queue_attributes = {
  .name = "uart_rx_queue"
};
/* Definitions for control_queue */
osMessageQueueId_t control_queueHandle;
const osMessageQueueAttr_t control_queue_attributes = {
  .name = "control_queue"
};
/* Definitions for uart_tx_mutex */
osMutexId_t uart_tx_mutexHandle;
const osMutexAttr_t uart_tx_mutex_attributes = {
  .name = "uart_tx_mutex"
};
/* USER CODE BEGIN PV */
#ifdef HAL_ADC_MODULE_ENABLED
static uint16_t Read_ADC_PC0(void);
#endif

static osThreadId_t SystemMonitorTaskHandle;
static const osThreadAttr_t SystemMonitorTask_attributes = {
  .name = "SystemMonitorTask",
  .stack_size = 256 * 4,
  .priority = (osPriority_t) osPriorityAboveNormal,
};

/* USER CODE END PV */

void SystemClock_Config(void);
static void MX_GPIO_Init(void);
static void MX_DMA_Init(void);
static void MX_USART2_UART_Init(void);
static void MX_TIM3_Init(void);
static void MX_USART1_UART_Init(void);
static void MX_I2C1_Init(void);
static void MX_TIM11_Init(void);
static void MX_I2S2_Init(void);
static void MX_IWDG_Init(void);
void StartDefaultTask(void *argument);
void StartUartRxTask(void *argument);
void StartControlTask(void *argument);
void StartSensorTask(void *argument);

/* USER CODE BEGIN PFP */
void StartSystemMonitorTask(void *argument);

/* USER CODE END PFP */

/* USER CODE BEGIN 0 */
int _write(int file, char *ptr, int len)
{
    (void)file;
    if ((ptr != NULL) && (len > 0)) {
      (void)HAL_UART_Transmit(&huart2, (uint8_t *)ptr, (uint16_t)len, 100U);
    }
    return len;
}
/* USER CODE END 0 */

/**
  * @brief  The application entry point.
  * @retval int
  */
int main(void)
{

  /* MCU Configuration--------------------------------------------------------*/

  /* Reset of all peripherals, Initializes the Flash interface and the Systick. */
  HAL_Init();

  /* Configure the system clock */
  SystemClock_Config();

  /* Initialize all configured peripherals */
  MX_GPIO_Init();
  MX_DMA_Init();
  MX_USART2_UART_Init();
  MX_TIM3_Init();
  MX_USART1_UART_Init();
  MX_I2C1_Init();
  MX_TIM11_Init();
  MX_I2S2_Init();
  MX_IWDG_Init();
  /* USER CODE BEGIN 2 */
  HAL_TIM_PWM_Start(&htim3, TIM_CHANNEL_1);
  __HAL_TIM_SET_COMPARE(&htim3, TIM_CHANNEL_1, 1500);
  //HAL_GPIO_WritePin(GPIOA, GPIO_PIN_5, GPIO_PIN_RESET);
  /* UART2 boot message is currently disabled */
  // const char *msg = "BOOT\r\n";
  // HAL_UART_Transmit(&huart2, (uint8_t*)msg, strlen(msg), 100);
  IR_LED_All_On();   // PB0, PB1, PB2 ON
  //IR_LED_All_Off(); // PB0, PB1, PB2 OFF
  // HAL_ADC_Start(&hadc1); // ADC path disabled (I2S path in use)
//  HAL_TIM_PWM_Start(&htim3, TIM_CHANNEL_1);

  const rpi_watchdog_cfg_t rpi_wdg_cfg = {
    .grace_sec = RPI_WDG_GRACE_SEC,
    .heartbeat_timeout_ms = RPI_HEARTBEAT_TIMEOUT_MS,
    .relay_cut_sec = RPI_RELAY_CUT_SEC,
    .poll_ms = RPI_WDG_POLL_MS,
    .uart_log_enable = (uint8_t)RPI_WDG_UART_LOG_ENABLE
  };
  const sys_watchdog_cfg_t sys_wdg_cfg = {
    .period_ms = SYS_MONITOR_PERIOD_MS,
    .miss_max = SYS_MONITOR_MISS_MAX
  };

  rpi_watchdog_init(&huart2, &rpi_wdg_cfg);
  sys_watchdog_init(&hiwdg, &sys_wdg_cfg);
  rpi_watchdog_log_boot_status(&hiwdg, sys_wdg_cfg.miss_max);

  app_init();

  /* USER CODE END 2 */

  /* Init scheduler */
  osKernelInitialize();
  /* Create the mutex(es) */
  /* creation of uart_tx_mutex */
  uart_tx_mutexHandle = osMutexNew(&uart_tx_mutex_attributes);

  /* USER CODE BEGIN RTOS_MUTEX */
  /* add mutexes, ... */
  /* USER CODE END RTOS_MUTEX */

  /* USER CODE BEGIN RTOS_SEMAPHORES */
  /* add semaphores, ... */
  /* USER CODE END RTOS_SEMAPHORES */

  /* USER CODE BEGIN RTOS_TIMERS */
  /* start timers, add new ones, ... */
  /* USER CODE END RTOS_TIMERS */

  /* Create the queue(s) */
  /* creation of uart_rx_queue */
  uart_rx_queueHandle = osMessageQueueNew (256, sizeof(uint8_t), &uart_rx_queue_attributes);

  /* creation of control_queue */
  control_queueHandle = osMessageQueueNew (64, sizeof(uint8_t), &control_queue_attributes);

  /* USER CODE BEGIN RTOS_QUEUES */
  /* add queues, ... */
  /* USER CODE END RTOS_QUEUES */

  /* Create the thread(s) */
  /* creation of defaultTask */
  defaultTaskHandle = osThreadNew(StartDefaultTask, NULL, &defaultTask_attributes);

  /* creation of UartRxTask */
  UartRxTaskHandle = osThreadNew(StartUartRxTask, NULL, &UartRxTask_attributes);

  /* creation of ControlTask */
  ControlTaskHandle = osThreadNew(StartControlTask, NULL, &ControlTask_attributes);

  /* creation of SensorTask */
  SensorTaskHandle = osThreadNew(StartSensorTask, NULL, &SensorTask_attributes);

  /* USER CODE BEGIN RTOS_THREADS */
  SystemMonitorTaskHandle = osThreadNew(StartSystemMonitorTask, NULL, &SystemMonitorTask_attributes);
  /* USER CODE END RTOS_THREADS */

  /* USER CODE BEGIN RTOS_EVENTS */
  /* add events, ... */
  /* USER CODE END RTOS_EVENTS */

  /* Start scheduler */
  osKernelStart();

  /* We should never get here as control is now taken by the scheduler */

  /* Infinite loop */
  /* USER CODE BEGIN WHILE */
  while (1)
  {
    /* USER CODE END WHILE */

    /* USER CODE BEGIN 3 */
  }
  /* USER CODE END 3 */
}

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
/* USER CODE BEGIN 4 */
#ifdef HAL_ADC_MODULE_ENABLED
static uint16_t Read_ADC_PC0(void)
{
  HAL_ADC_Start(&hadc1);

  if (HAL_ADC_PollForConversion(&hadc1, 10) != HAL_OK) {
    HAL_ADC_Stop(&hadc1);
    return 0;
  }

  uint16_t v = (uint16_t)HAL_ADC_GetValue(&hadc1);
  HAL_ADC_Stop(&hadc1);
  return v;
}
#endif

void StartSystemMonitorTask(void *argument)
{
  sys_watchdog_task(argument);
}
/* USER CODE END 4 */

/* USER CODE BEGIN Header_StartDefaultTask */
/**
  * @brief  Function implementing the defaultTask thread.
  * @param  argument: Not used
  * @retval None
  */
/* USER CODE END Header_StartDefaultTask */
void StartDefaultTask(void *argument)
{
  /* USER CODE BEGIN 5 */
  rpi_watchdog_task(argument);
  /* USER CODE END 5 */
}

/* USER CODE BEGIN Header_StartUartRxTask */
/**
* @brief Function implementing the UartRxTask thread.
* @param argument: Not used
* @retval None
*/
/* USER CODE END Header_StartUartRxTask */
void StartUartRxTask(void *argument)
{
  /* USER CODE BEGIN StartUartRxTask */
  uint8_t rx_byte = 0U;

  /* Infinite loop */
  for(;;)
  {
    if (osMessageQueueGet(uart_rx_queueHandle, &rx_byte, NULL, osWaitForever) == osOK) {
      app_on_uart1_byte(rx_byte);
    }
  }
  /* USER CODE END StartUartRxTask */
}

/* USER CODE BEGIN Header_StartControlTask */
/**
* @brief Function implementing the ControlTask thread.
* @param argument: Not used
* @retval None
*/
/* USER CODE END Header_StartControlTask */
void StartControlTask(void *argument)
{
  /* USER CODE BEGIN StartControlTask */
  /* Infinite loop */
  for(;;)
  {
    app_control_loop();
    osDelay(10);
  }
  /* USER CODE END StartControlTask */
}

/* USER CODE BEGIN Header_StartSensorTask */
/**
* @brief Function implementing the SensorTask thread.
* @param argument: Not used
* @retval None
*/
/* USER CODE END Header_StartSensorTask */
void StartSensorTask(void *argument)
{
  /* USER CODE BEGIN StartSensorTask */
  /* Infinite loop */
  for(;;)
  {
    app_sensor_loop();
    osDelay(20);
  }
  /* USER CODE END StartSensorTask */
}

/**
  * @brief  Period elapsed callback in non blocking mode
  * @note   This function is called  when TIM1 interrupt took place, inside
  * HAL_TIM_IRQHandler(). It makes a direct call to HAL_IncTick() to increment
  * a global variable "uwTick" used as application time base.
  * @param  htim : TIM handle
  * @retval None
  */
void HAL_TIM_PeriodElapsedCallback(TIM_HandleTypeDef *htim)
{
  if (htim->Instance == TIM1)
  {
    HAL_IncTick();
  }
}

/**
  * @brief  This function is executed in case of error occurrence.
  * @retval None
  */
void Error_Handler(void)
{
  /* USER CODE BEGIN Error_Handler_Debug */
  /* User can add his own implementation to report the HAL error return state */
  __disable_irq();
  while (1)
  {
  }
  /* USER CODE END Error_Handler_Debug */
}
#ifdef USE_FULL_ASSERT
/**
  * @brief  Reports the name of the source file and the source line number
  *         where the assert_param error has occurred.
  * @param  file: pointer to the source file name
  * @param  line: assert_param error line source number
  * @retval None
  */
void assert_failed(uint8_t *file, uint32_t line)
{
  /* USER CODE BEGIN 6 */
  /* User can add his own implementation to report the file name and line number,
     ex: printf("Wrong parameters value: file %s on line %d\r\n", file, line) */
  /* USER CODE END 6 */
}
#endif /* USE_FULL_ASSERT */
