veda-Anomap/Edgedevice_stm32/irrled.ioc

Mcu.UserName=STM32F401RETx
PA10.Signal=USART1_RX
PA2.Signal=USART2_TX
PA3.Signal=USART2_RX
PA4.Signal=ADCx_IN4
PA5.Signal=ADCx_IN5
PA6.Signal=S_TIM3_CH1
PA7.Signal=S_TIM3_CH2
PA9.Signal=USART1_TX
PB0.Signal=GPIO_Output
PB1.Signal=GPIO_Output
PB12.Signal=I2S2_WS
PB13.Signal=I2S2_CK
PB15.Signal=I2S2_SD
PB2.Signal=GPIO_Output
PB8.Signal=I2C1_SCL
PB9.Signal=I2C1_SDA
PC0.Signal=ADCx_IN10
PC10.GPIO_Label=RELAY_EN
PC10.Signal=GPIO_Output
PC3.GPIO_Label=RPI_HB
PC3.Signal=GPIO_Input
