veda-Anomap/Edgedevice_stm32/Core/Inc/main.h

#define RPI_HB_Pin GPIO_PIN_3
#define RPI_HB_GPIO_Port GPIOC
#define RELAY_EN_Pin GPIO_PIN_10
#define RELAY_EN_GPIO_Port GPIOC
