veda-Anomap/Edgedevice_stm32/Core/Src/app.c

#include "app.h"
#include "mic.h"
#include "motor_ctrl.h"
#include "aht10.h"
#include "pcf8591.h"
#include "cmsis_os2.h"
#include <stdio.h>
#include <string.h>
#include <ctype.h>

extern TIM_HandleTypeDef htim3;
extern I2C_HandleTypeDef hi2c1;
extern UART_HandleTypeDef huart1;
extern UART_HandleTypeDef huart2;
extern osMessageQueueId_t uart_rx_queueHandle;
extern osMessageQueueId_t control_queueHandle;
extern osMutexId_t uart_tx_mutexHandle;

typedef enum {
    MODE_AUTO = 0,
    MODE_MANUAL
} SystemMode_t;

static volatile SystemMode_t current_mode = MODE_AUTO;
static uint8_t rx_data = 0U;
static uint8_t rx_data_rpi = 0U;

#define PROTO_MAX_PAYLOAD 192U
#define PROTO_FRAME_QUEUE_LEN 8U
#define PROTO_TX_QUEUE_LEN 8U
#define PROTO_TX_FRAME_MAX (5U + PROTO_MAX_PAYLOAD)
#define PROTO_RX_TIMEOUT_MS 100U
#define STATUS_REPLY_MIN_INTERVAL_MS 100U
#define MANUAL_CMD_MIN_INTERVAL_MS 90U
#define TDOA_FALLBACK_HOLD_MS 250U
#define TDOA_LOST_CONFIRM_CYCLES 3U
#define AUTO_VIEW_HOLD_MS 1000U
#define AUTO_USE_DETECT_FALLBACK 1U
#define TDOA_OK_MIN_ABS_X10 50
#define TDOA_STRONG_CONFIRM_CYCLES 2U
#define EVENT_FASTPATH_ENABLE 1U
#define EVENT_LEVEL_TH 1400U
#define EVENT_RISE_TH 180U
#define EVENT_COOLDOWN_MS 300U
#define EVENT_HOLD_MS 700U
#define EVENT_FALLBACK_ANGLE_X10 450
#define EVENT_FALLBACK_RATIO_Q8 320U
#define TDIR_ENTER_X10 90
#define TDIR_EXIT_X10  60
#define TDIR_FLIP_X10  180
#define UART1_RX_MIRROR_TO_UART2 0U
#define UART1_MIRROR_PAYLOAD_MAX 96U

typedef enum {
    PROTO_RX_WAIT_CMD = 0,
    PROTO_RX_WAIT_LEN_0,
    PROTO_RX_WAIT_LEN_1,
    PROTO_RX_WAIT_LEN_2,
    PROTO_RX_WAIT_LEN_3,
    PROTO_RX_WAIT_PAYLOAD
} proto_rx_state_t;

static volatile proto_rx_state_t s_proto_state = PROTO_RX_WAIT_CMD;
static volatile uint8_t s_proto_cmd = 0U;
static volatile uint32_t s_proto_len = 0U;
static volatile uint32_t s_proto_idx = 0U;
static uint8_t s_proto_rx_buf[PROTO_MAX_PAYLOAD];
static volatile uint32_t s_proto_last_byte_ms = 0U;

typedef struct {
    uint8_t cmd;
    uint32_t len;
    uint8_t payload[PROTO_MAX_PAYLOAD];
} proto_frame_t;

typedef struct {
    uint16_t len;
    uint8_t data[PROTO_TX_FRAME_MAX];
} proto_tx_frame_t;

static proto_frame_t s_frame_q[PROTO_FRAME_QUEUE_LEN];
static volatile uint8_t s_frame_q_head = 0U;
static volatile uint8_t s_frame_q_tail = 0U;
static volatile uint8_t s_frame_q_count = 0U;
static proto_tx_frame_t s_tx_q[PROTO_TX_QUEUE_LEN];
static volatile uint8_t s_tx_q_head = 0U;
static volatile uint8_t s_tx_q_tail = 0U;
static volatile uint8_t s_tx_q_count = 0U;
static volatile uint8_t s_tx_busy = 0U;
static volatile uint8_t s_tx_need_kick = 0U;
static volatile uint8_t s_status_reply_pending = 0U;
static volatile uint32_t s_last_status_reply_ms = 0U;

/* UART1 (RPi) diagnostic counters */
static volatile uint32_t s_u1_isr_bytes = 0U;
static volatile uint32_t s_u1_frames = 0U;
static volatile uint32_t s_u1_queue_drop = 0U;
static volatile uint32_t s_u1_proto_oversize = 0U;
static volatile uint32_t s_u1_proto_invalid = 0U;
static volatile uint32_t s_u1_status_req = 0U;
static volatile uint32_t s_u1_motor_req = 0U;
static volatile uint32_t s_u1_ack_ok = 0U;
static volatile uint32_t s_u1_ack_fail = 0U;
static volatile uint32_t s_u1_err_total = 0U;
static volatile uint32_t s_u1_err_ore = 0U;
static volatile uint32_t s_u1_err_fe = 0U;
static volatile uint32_t s_u1_err_ne = 0U;
static volatile uint32_t s_u1_err_pe = 0U;
static volatile uint32_t s_u1_rearm_fail = 0U;
static volatile uint32_t s_u1_recover_ok = 0U;
static volatile uint32_t s_u1_recover_fail = 0U;
static volatile uint32_t s_u1_tx_drop = 0U;
static volatile uint32_t s_u1_tx_it_fail = 0U;
static volatile char s_auto_ctrl_src = 'D'; /* D: detect_dir, T: tdoa */

/* Coalesce manual move bursts: keep only the latest movement command */
static uint8_t s_pending_move_cmd = 0U;
static uint32_t s_last_move_apply_ms = 0U;

static void uart2_mirror_uart1_frame(uint8_t cmd, const uint8_t *payload, uint32_t len)
{
#if UART1_RX_MIRROR_TO_UART2
    char payload_txt[UART1_MIRROR_PAYLOAD_MAX + 1U];
    uint32_t copy_len = 0U;
    const char *tail = "";

    if ((payload != NULL) && (len > 0U)) {
        copy_len = (len > UART1_MIRROR_PAYLOAD_MAX) ? UART1_MIRROR_PAYLOAD_MAX : len;
        for (uint32_t i = 0U; i < copy_len; i++) {
            const uint8_t ch = payload[i];
            payload_txt[i] = ((ch >= 32U) && (ch <= 126U)) ? (char)ch : '.';
        }
        payload_txt[copy_len] = '\0';
        if (len > copy_len) {
            tail = "...";
        }
    } else {
        payload_txt[0] = '\0';
    }

    char line[220];
    int n = snprintf(line, sizeof(line),
                     "[U1->STM] CMD:0x%02X LEN:%lu PAYLOAD:%s%s\r\n",
                     (unsigned)cmd, (unsigned long)len, payload_txt, tail);
    if (n > 0) {
        const uint16_t tx_len = (n < (int)sizeof(line)) ? (uint16_t)n : (uint16_t)(sizeof(line) - 1U);
        (void)HAL_UART_Transmit(&huart2, (uint8_t *)line, tx_len, 50U);
    }
#else
    (void)cmd;
    (void)payload;
    (void)len;
#endif
}

/* Convert PWM range to 0~180 degree scale */
static int32_t pwm_to_deg(uint16_t pwm, uint16_t min_pwm, uint16_t max_pwm)
{
    if (max_pwm <= min_pwm) return 0;
    if (pwm < min_pwm) pwm = min_pwm;
    if (pwm > max_pwm) pwm = max_pwm;
    return ((int32_t)(pwm - min_pwm) * 180) / (int32_t)(max_pwm - min_pwm);
}

static uint8_t proto_uart1_enqueue_frame(uint8_t cmd, const char *json)
{
    if (json == NULL) return 0U;

    const uint32_t payload_len = (uint32_t)strlen(json);
    if (payload_len > PROTO_MAX_PAYLOAD) {
        s_u1_tx_drop++;
        return 0U;
    }

    proto_tx_frame_t frame = {0};
    frame.data[0] = cmd;
    frame.data[1] = (uint8_t)((payload_len >> 24) & 0xFFU);
    frame.data[2] = (uint8_t)((payload_len >> 16) & 0xFFU);
    frame.data[3] = (uint8_t)((payload_len >> 8) & 0xFFU);
    frame.data[4] = (uint8_t)(payload_len & 0xFFU);
    if (payload_len > 0U) {
        memcpy(&frame.data[5], json, payload_len);
    }
    frame.len = (uint16_t)(5U + payload_len);

    uint8_t queued = 0U;
    __disable_irq();
    if (s_tx_q_count < PROTO_TX_QUEUE_LEN) {
        s_tx_q[s_tx_q_head] = frame;
        s_tx_q_head = (uint8_t)((s_tx_q_head + 1U) % PROTO_TX_QUEUE_LEN);
        s_tx_q_count++;
        s_tx_need_kick = 1U;
        queued = 1U;
    } else {
        s_u1_tx_drop++;
    }
    __enable_irq();

    return queued;
}

static void proto_uart1_tx_poll(void)
{
    if (s_tx_busy != 0U) return;
    if (s_tx_need_kick == 0U) return;

    uint8_t *tx_ptr = NULL;
    uint16_t tx_len = 0U;

    __disable_irq();
    if (s_tx_q_count > 0U) {
        tx_ptr = s_tx_q[s_tx_q_tail].data;
        tx_len = s_tx_q[s_tx_q_tail].len;
    } else {
        s_tx_need_kick = 0U;
    }
    __enable_irq();

    if ((tx_ptr == NULL) || (tx_len == 0U)) return;

    if (HAL_UART_Transmit_IT(&huart1, tx_ptr, tx_len) == HAL_OK) {
        s_tx_busy = 1U;
    } else {
        s_u1_tx_it_fail++;
        s_tx_need_kick = 1U;
    }
}

static uint8_t proto_uart1_send_packet(uint8_t cmd, const char *json)
{
    const uint8_t ok = proto_uart1_enqueue_frame(cmd, json);
    proto_uart1_tx_poll();
    return ok;
}

static uint8_t proto_send_status_packet(void)
{
    aht10_data_t th = {0};
    pcf8591_data_t light = {0};
    mic_debug_t dbg = {0};
    char dir = '-';

    if (mic_is_calibrated()) {
        mic_get_debug(&dbg);
        dir = dbg.detect_dir;
    }
    aht10_get_data(&th);
    pcf8591_get_data(&light);

    const uint16_t tilt_pwm = motor_ctrl_get_tilt_pwm();
    const int32_t tilt_deg = pwm_to_deg(tilt_pwm, TILT_UP, TILT_DOWN);
    const int32_t t_abs = (th.temperature_c_x100 < 0) ? -th.temperature_c_x100 : th.temperature_c_x100;

    char temp_buf[16];
    if (th.temperature_c_x100 < 0) {
        (void)snprintf(temp_buf, sizeof(temp_buf), "-%ld.%02ld",
                       (long)(t_abs / 100), (long)(t_abs % 100));
    } else {
        (void)snprintf(temp_buf, sizeof(temp_buf), "%ld.%02ld",
                       (long)(t_abs / 100), (long)(t_abs % 100));
    }

    char json[160];
    (void)snprintf(json, sizeof(json),
                   "{\"tmp\":%s,\"hum\":%lu.%02lu,\"dir\":\"%c\",\"tilt\":%ld,\"light\":%lu}",
                   temp_buf,
                   (unsigned long)(th.humidity_rh_x100 / 100U),
                   (unsigned long)(th.humidity_rh_x100 % 100U),
                   dir,
                   (long)tilt_deg,
                   (unsigned long)light.light_raw);

    return proto_uart1_send_packet(0x05U, json);
}

static void proto_send_motor_ack(uint8_t ok, const char *cmd_text)
{
    const char *mode_str = (current_mode == MODE_AUTO) ? "auto" : "manual";
    char json[96];
    (void)snprintf(json, sizeof(json),
                   "{\"ok\":%u,\"mode\":\"%s\",\"cmd\":\"%s\"}",
                   (unsigned)ok, mode_str, (cmd_text != NULL) ? cmd_text : "");
    (void)proto_uart1_send_packet(0x04U, json);
}

static void proto_publish_frame(uint8_t cmd, const uint8_t *payload, uint32_t len)
{
    if (len > PROTO_MAX_PAYLOAD) return;

    __disable_irq();
    if (s_frame_q_count < PROTO_FRAME_QUEUE_LEN) {
        proto_frame_t *slot = &s_frame_q[s_frame_q_head];
        slot->cmd = cmd;
        slot->len = len;
        if ((len > 0U) && (payload != NULL)) {
            memcpy(slot->payload, payload, len);
        }
        s_frame_q_head = (uint8_t)((s_frame_q_head + 1U) % PROTO_FRAME_QUEUE_LEN);
        s_frame_q_count++;
    } else {
        /* Queue full: count dropped frame as invalid for diagnostics */
        s_u1_proto_invalid++;
    }
    __enable_irq();
}

static void proto_rx_reset(void)
{
    s_proto_state = PROTO_RX_WAIT_CMD;
    s_proto_cmd = 0U;
    s_proto_len = 0U;
    s_proto_idx = 0U;
    s_proto_last_byte_ms = 0U;
}

static void proto_rx_feed_byte(uint8_t b)
{
    switch (s_proto_state) {
    case PROTO_RX_WAIT_CMD:
        if ((b != 0x04U) && (b != 0x05U)) {
            s_u1_proto_invalid++;
            break;
        }
        s_proto_cmd = b;
        s_proto_len = 0U;
        s_proto_idx = 0U;
        s_proto_state = PROTO_RX_WAIT_LEN_0;
        break;

    case PROTO_RX_WAIT_LEN_0:
        s_proto_len = ((uint32_t)b << 24);
        s_proto_state = PROTO_RX_WAIT_LEN_1;
        break;

    case PROTO_RX_WAIT_LEN_1:
        s_proto_len |= ((uint32_t)b << 16);
        s_proto_state = PROTO_RX_WAIT_LEN_2;
        break;

    case PROTO_RX_WAIT_LEN_2:
        s_proto_len |= ((uint32_t)b << 8);
        s_proto_state = PROTO_RX_WAIT_LEN_3;
        break;

    case PROTO_RX_WAIT_LEN_3:
        s_proto_len |= (uint32_t)b;
        if (s_proto_len > PROTO_MAX_PAYLOAD) {
            s_u1_proto_oversize++;
            proto_rx_reset();
            break;
        }
        if (s_proto_len == 0U) {
            proto_publish_frame(s_proto_cmd, NULL, 0U);
            proto_rx_reset();
        } else {
            s_proto_idx = 0U;
            s_proto_state = PROTO_RX_WAIT_PAYLOAD;
        }
        break;

    case PROTO_RX_WAIT_PAYLOAD:
        if (s_proto_idx < PROTO_MAX_PAYLOAD) {
            s_proto_rx_buf[s_proto_idx++] = b;
        }
        if (s_proto_idx >= s_proto_len) {
            proto_publish_frame(s_proto_cmd, s_proto_rx_buf, s_proto_len);
            proto_rx_reset();
        }
        break;

    default:
        proto_rx_reset();
        break;
    }
}

static uint8_t proto_pop_frame(uint8_t *cmd, uint8_t *payload, uint32_t *len)
{
    uint8_t has_frame = 0U;

    __disable_irq();
    if (s_frame_q_count > 0U) {
        const proto_frame_t *slot = &s_frame_q[s_frame_q_tail];
        *cmd = slot->cmd;
        *len = slot->len;
        if (*len > 0U) {
            memcpy(payload, slot->payload, *len);
        }
        s_frame_q_tail = (uint8_t)((s_frame_q_tail + 1U) % PROTO_FRAME_QUEUE_LEN);
        s_frame_q_count--;
        has_frame = 1U;
    }
    __enable_irq();

    return has_frame;
}

static char parse_motor_command(const uint8_t *payload, uint32_t len, char *cmd_text, uint32_t cmd_text_size)
{
    if (payload == NULL || len == 0U || cmd_text == NULL || cmd_text_size == 0U) return 0;
    if (len > PROTO_MAX_PAYLOAD) return 0;

    char msg[PROTO_MAX_PAYLOAD + 1U];
    memcpy(msg, payload, len);
    msg[len] = '\0';

    for (uint32_t i = 0U; i < len; i++) {
        msg[i] = (char)tolower((unsigned char)msg[i]);
    }

    const char *k = strstr(msg, "motor");
    if (k == NULL) return 0;

    const char *colon = strchr(k, ':');
    if (colon == NULL) return 0;
    colon++;
    while (*colon == ' ' || *colon == '\t') {
        colon++;
    }

    char token[16] = {0};
    uint32_t ti = 0U;
    if (*colon == '\"') {
        colon++;
        while (*colon != '\0' && *colon != '\"' && ti < (sizeof(token) - 1U)) {
            token[ti++] = *colon++;
        }
    } else {
        while (*colon != '\0' && *colon != ',' && *colon != '}' && ti < (sizeof(token) - 1U)) {
            token[ti++] = *colon++;
        }
    }
    token[ti] = '\0';

    (void)snprintf(cmd_text, cmd_text_size, "%s", token);

    /* RPi protocol allow-list: a/s/w/d/auto/unauto */
    if (strcmp(token, "auto") == 0) return 'o';
    if (strcmp(token, "unauto") == 0) return 'f';
    if (strcmp(token, "w") == 0) return 'w';
    if (strcmp(token, "a") == 0) return 'a';
    if (strcmp(token, "s") == 0) return 's';
    if (strcmp(token, "d") == 0) return 'd';

    return 0;
}

static uint8_t push_control_command(uint8_t cmd)
{
    if (control_queueHandle == NULL) return 0U;
    return (osMessageQueuePut(control_queueHandle, &cmd, 0U, 0U) == osOK) ? 1U : 0U;
}

static void process_protocol_frame(uint8_t cmd, const uint8_t *payload, uint32_t len, uint32_t now_ms)
{
    if (cmd == 0x05U) {
        if (len == 0U) {
            s_u1_status_req++;
            if ((now_ms - s_last_status_reply_ms) >= STATUS_REPLY_MIN_INTERVAL_MS) {
                if (proto_send_status_packet() != 0U) {
                    s_last_status_reply_ms = now_ms;
                    s_status_reply_pending = 0U;
                } else {
                    /* TX queue full: keep pending for retry */
                    s_status_reply_pending = 1U;
                }
            } else {
                s_status_reply_pending = 1U;
            }
        } else {
            s_u1_proto_invalid++;
            if (proto_uart1_send_packet(0x05U, "") == 0U) {
                s_status_reply_pending = 1U;
            }
        }
        return;
    }

    if (cmd == 0x04U) {
        s_u1_motor_req++;
        char cmd_text[16] = {0};
        const char motor_cmd = parse_motor_command(payload, len, cmd_text, sizeof(cmd_text));
        if (motor_cmd != 0) {
            const uint8_t queued = push_control_command((uint8_t)motor_cmd);
            if (queued != 0U) {
                s_u1_ack_ok++;
            } else {
                s_u1_ack_fail++;
            }
            proto_send_motor_ack(queued, cmd_text);
        } else {
            s_u1_proto_invalid++;
            s_u1_ack_fail++;
            proto_send_motor_ack(0U, "invalid");
        }
        return;
    }

    s_u1_proto_invalid++;
}

static void uart1_recover_rx_error(uint32_t err_flags)
{
    /* FE/NE/ORE/PE error recovery:
     * HAL clear macros internally perform the SR->DR clear sequence.
     * Do recovery only when needed to reduce impact on RX throughput. */
    if ((err_flags & (HAL_UART_ERROR_ORE | HAL_UART_ERROR_FE |
                      HAL_UART_ERROR_NE  | HAL_UART_ERROR_PE)) != 0U) {
        __HAL_UART_CLEAR_PEFLAG(&huart1);
    }
    __HAL_UART_CLEAR_IDLEFLAG(&huart1);

    if (HAL_UART_Receive_IT(&huart1, &rx_data_rpi, 1) == HAL_OK) {
        s_u1_recover_ok++;
        return;
    }

    s_u1_rearm_fail++;

    /* If rearm fails in busy state, abort receive and rearm once again */
    (void)HAL_UART_AbortReceive_IT(&huart1);

    if ((err_flags & (HAL_UART_ERROR_ORE | HAL_UART_ERROR_FE |
                      HAL_UART_ERROR_NE  | HAL_UART_ERROR_PE)) != 0U) {
        __HAL_UART_CLEAR_PEFLAG(&huart1);
    }
    __HAL_UART_CLEAR_IDLEFLAG(&huart1);

    if (HAL_UART_Receive_IT(&huart1, &rx_data_rpi, 1) == HAL_OK) {
        s_u1_recover_ok++;
    } else {
        s_u1_rearm_fail++;
        s_u1_recover_fail++;
    }
}

void app_on_uart1_byte(uint8_t b)
{
    const uint32_t now = HAL_GetTick();

    if ((s_proto_state != PROTO_RX_WAIT_CMD) &&
        ((now - s_proto_last_byte_ms) > PROTO_RX_TIMEOUT_MS)) {
        s_u1_proto_invalid++;
        proto_rx_reset();
    }
    s_proto_last_byte_ms = now;
    proto_rx_feed_byte(b);
}

static void drain_protocol_queue(uint32_t now_ms)
{
    uint8_t frame_cmd = 0U;
    uint32_t frame_len = 0U;
    uint8_t frame_payload[PROTO_MAX_PAYLOAD];

    while (proto_pop_frame(&frame_cmd, frame_payload, &frame_len) != 0U) {
        s_u1_frames++;
        uart2_mirror_uart1_frame(frame_cmd, frame_payload, frame_len);
        process_protocol_frame(frame_cmd, frame_payload, frame_len, now_ms);
    }
}

static void apply_control_command(uint8_t cmd)
{
    /* Mode command:
     * - 'o' (on): auto mode
     * - 'f' (off): manual mode
     */
    if (cmd == 'o' || cmd == 'O') {
        current_mode = MODE_AUTO;
        motor_ctrl_enter_auto();
        return;
    }
    if (cmd == 'f' || cmd == 'F') {
        current_mode = MODE_MANUAL;
        motor_ctrl_enter_manual();
        return;
    }

    /* Manual movement commands:
     * if a movement command arrives in AUTO mode,
     * switch to MANUAL first and then apply movement.
     */
    if (cmd == 'W' || cmd == 'w' || cmd == 'S' || cmd == 's' ||
        cmd == 'A' || cmd == 'a' || cmd == 'D' || cmd == 'd') {
        if (current_mode != MODE_MANUAL) {
            current_mode = MODE_MANUAL;
            motor_ctrl_enter_manual();
        }

        if (cmd == 'W' || cmd == 'w') {
            manual_move_tilt(-50);
            return;
        }
        if (cmd == 'S' || cmd == 's') {
            manual_move_tilt(+50);
            return;
        }
        if (cmd == 'A' || cmd == 'a') {
            manual_move_pan(-50);
            return;
        }
        if (cmd == 'D' || cmd == 'd') {
            manual_move_pan(+50);
            return;
        }
    }
}

static uint8_t is_move_command(uint8_t cmd)
{
    return (cmd == 'W' || cmd == 'w' ||
            cmd == 'A' || cmd == 'a' ||
            cmd == 'S' || cmd == 's' ||
            cmd == 'D' || cmd == 'd') ? 1U : 0U;
}

static uint8_t is_mode_command(uint8_t cmd)
{
    return (cmd == 'O' || cmd == 'o' || cmd == 'F' || cmd == 'f') ? 1U : 0U;
}

static void drain_control_queue(uint32_t now_ms)
{
    if (control_queueHandle == NULL) return;

    uint8_t cmd = 0U;
    while (osMessageQueueGet(control_queueHandle, &cmd, NULL, 0U) == osOK) {
        if (is_mode_command(cmd) != 0U) {
            /* Apply mode switch immediately */
            s_pending_move_cmd = 0U;
            apply_control_command(cmd);
            continue;
        }

        if (is_move_command(cmd) != 0U) {
            /* For move bursts, keep only the latest command (coalescing) */
            s_pending_move_cmd = cmd;
            continue;
        }

        /* Future extension commands are applied immediately */
        apply_control_command(cmd);
    }

    if ((s_pending_move_cmd != 0U) &&
        ((now_ms - s_last_move_apply_ms) >= MANUAL_CMD_MIN_INTERVAL_MS)) {
        apply_control_command(s_pending_move_cmd);
        s_last_move_apply_ms = now_ms;
        s_pending_move_cmd = 0U;
    }
}

void app_init(void)
{
    motor_ctrl_init(&htim3);
    mic_init();
    mic_tdoa_enable(1U);
    aht10_init(&hi2c1, 2000U);
    pcf8591_init(&hi2c1, 200U);

    /* Enable first UART RX interrupt (1 byte command) */
    (void)HAL_UART_Receive_IT(&huart2, &rx_data, 1);
    /* RPi protocol RX interrupt (frame by frame, 1 byte feed) */
    (void)HAL_UART_Receive_IT(&huart1, &rx_data_rpi, 1);

    /* UART2 direction-only monitor mode: boot banner disabled */
}

#ifdef HAL_ADC_MODULE_ENABLED
void HAL_ADC_ConvCpltCallback(ADC_HandleTypeDef *hadc)
{
    mic_on_dma_complete(hadc);
}
#endif

#ifdef HAL_I2S_MODULE_ENABLED
void HAL_I2S_RxHalfCpltCallback(I2S_HandleTypeDef *hi2s)
{
    mic_on_i2s_rx_half_complete(hi2s);
}

void HAL_I2S_RxCpltCallback(I2S_HandleTypeDef *hi2s)
{
    mic_on_i2s_rx_complete(hi2s);
}
#endif

void HAL_UART_RxCpltCallback(UART_HandleTypeDef *huart)
{
    if (huart == &huart2) {
        (void)push_control_command(rx_data);
        (void)HAL_UART_Receive_IT(&huart2, &rx_data, 1);
        return;
    }

    if (huart == &huart1) {
        s_u1_isr_bytes++;
        if (uart_rx_queueHandle != NULL) {
            if (osMessageQueuePut(uart_rx_queueHandle, &rx_data_rpi, 0U, 0U) != osOK) {
                s_u1_queue_drop++;
            }
        }
        if (HAL_UART_Receive_IT(&huart1, &rx_data_rpi, 1) != HAL_OK) {
            s_u1_rearm_fail++;
        }
        return;
    }
}

void HAL_UART_TxCpltCallback(UART_HandleTypeDef *huart)
{
    if (huart == &huart1) {
        uint8_t *next_ptr = NULL;
        uint16_t next_len = 0U;

        __disable_irq();
        if (s_tx_q_count > 0U) {
            s_tx_q_tail = (uint8_t)((s_tx_q_tail + 1U) % PROTO_TX_QUEUE_LEN);
            s_tx_q_count--;
        }
        s_tx_busy = 0U;
        if (s_tx_q_count > 0U) {
            next_ptr = s_tx_q[s_tx_q_tail].data;
            next_len = s_tx_q[s_tx_q_tail].len;
            s_tx_need_kick = 1U;
        } else {
            s_tx_need_kick = 0U;
        }
        __enable_irq();

        /* Keep TX continuous without waiting ControlTask period. */
        if ((next_ptr != NULL) && (next_len > 0U)) {
            if (HAL_UART_Transmit_IT(&huart1, next_ptr, next_len) == HAL_OK) {
                s_tx_busy = 1U;
                s_tx_need_kick = 0U;
            } else {
                s_u1_tx_it_fail++;
                s_tx_need_kick = 1U;
            }
        }
    }
}

void HAL_UART_ErrorCallback(UART_HandleTypeDef *huart)
{
    if (huart == &huart1) {
        const uint32_t e = huart->ErrorCode;
        s_u1_err_total++;
        if ((e & HAL_UART_ERROR_ORE) != 0U) s_u1_err_ore++;
        if ((e & HAL_UART_ERROR_FE) != 0U) s_u1_err_fe++;
        if ((e & HAL_UART_ERROR_NE) != 0U) s_u1_err_ne++;
        if ((e & HAL_UART_ERROR_PE) != 0U) s_u1_err_pe++;

        uart1_recover_rx_error(e);
        return;
    }

    if (huart == &huart2) {
        (void)HAL_UART_Receive_IT(&huart2, &rx_data, 1);
    }
}

void app_control_loop(void)
{
    const uint32_t nowm = HAL_GetTick();
    static uint32_t last_tdoa_ok_ms = 0U;
    static uint32_t last_event_ms = 0U;
    static uint32_t prev_event_lvl = 0U;
    static uint8_t tdoa_strong_confirm = 0U;
    static uint8_t tdoa_lost_confirm = 0U;
    static uint32_t auto_hold_until_ms = 0U;
    static int32_t auto_hold_angle_x10 = 0;
    static char auto_hold_dir = '-';
    static uint8_t auto_hold_src = 0U; /* 0:none, 1:tdoa, 2:detect_dir */

#ifdef HAL_I2S_MODULE_ENABLED
    /* Keep ISR short: consume queued I2S DMA segments in task context. */
    mic_i2s_drain(4U);
#endif

    if (current_mode == MODE_AUTO) {
        mic_tdoa_process(nowm);
    }

    /* Non-blocking UART1 TX queue progression */
    proto_uart1_tx_poll();

    /* Process completed UART1 frames in ControlTask context */
    drain_protocol_queue(nowm);

    if ((s_status_reply_pending != 0U) &&
        ((nowm - s_last_status_reply_ms) >= STATUS_REPLY_MIN_INTERVAL_MS)) {
        if (proto_send_status_packet() != 0U) {
            s_last_status_reply_ms = nowm;
            s_status_reply_pending = 0U;
        }
    }

    /* Apply UART/protocol commands only in ControlTask */
    drain_control_queue(nowm);

    if (current_mode == MODE_AUTO) {
        /* Hold behavior:
         * - src=1(TDOA): keep looking at last latched loud-direction angle.
         * - src=2(DETECT): keep short fallback direction hold. */
        if ((int32_t)(nowm - auto_hold_until_ms) < 0) {
            if (auto_hold_src == 1U) {
                s_auto_ctrl_src = 'H';
                motor_ctrl_track_pan_tdoa(nowm, auto_hold_angle_x10);
                return;
            }
            if (auto_hold_src == 2U) {
                s_auto_ctrl_src = 'H';
                motor_ctrl_process(nowm, auto_hold_dir);
                return;
            }
        } else {
            auto_hold_src = 0U;
            auto_hold_dir = '-';
        }

        mic_debug_t mdbg = {0};
        if (mic_is_calibrated()) {
            mic_get_debug(&mdbg);
        }
        const uint8_t detect_active = ((mdbg.gate_sound != 0U) &&
                                       (mdbg.gate_snr != 0U) &&
                                       (mdbg.gate_ratio != 0U)) ? 1U : 0U;

        mic_tdoa_debug_t tdbg = {0};
        mic_get_tdoa_debug(&tdbg);

#if EVENT_FASTPATH_ENABLE
        {
            const uint32_t event_lvl = (mdbg.peak_l > mdbg.peak_r) ? mdbg.peak_l : mdbg.peak_r;
            const uint32_t event_rise = (event_lvl > prev_event_lvl) ? (event_lvl - prev_event_lvl) : 0U;
            const uint8_t event_cool_ok = ((nowm - last_event_ms) >= EVENT_COOLDOWN_MS) ? 1U : 0U;
            const uint8_t event_trigger = ((event_lvl >= EVENT_LEVEL_TH) &&
                                           (event_rise >= EVENT_RISE_TH) &&
                                           (event_cool_ok != 0U)) ? 1U : 0U;
            prev_event_lvl = event_lvl;

            int32_t event_angle_x10 = 0;
            uint8_t event_angle_ok = 0U;
            if (tdbg.valid != 0U) {
                event_angle_x10 = tdbg.alpha_deg_x10;
                event_angle_ok = 1U;
            } else {
                const uint32_t pL = mdbg.peak_l;
                const uint32_t pR = mdbg.peak_r;
                uint32_t hi = (pL > pR) ? pL : pR;
                uint32_t lo = (pL > pR) ? pR : pL;
                if (lo == 0U) lo = 1U;
                const uint32_t ratio_q8 = (hi << 8) / lo;
                if (ratio_q8 >= EVENT_FALLBACK_RATIO_Q8) {
                    event_angle_x10 = (pL > pR) ? -EVENT_FALLBACK_ANGLE_X10 : EVENT_FALLBACK_ANGLE_X10;
                    event_angle_ok = 1U;
                }
            }

            if ((event_trigger != 0U) && (event_angle_ok != 0U)) {
                auto_hold_angle_x10 = event_angle_x10;
                auto_hold_src = 1U;
                auto_hold_until_ms = nowm + EVENT_HOLD_MS;
                last_event_ms = nowm;
                tdoa_strong_confirm = 0U;
                tdoa_lost_confirm = 0U;
                last_tdoa_ok_ms = nowm;
                s_auto_ctrl_src = 'E';
                motor_ctrl_track_pan_tdoa(nowm, auto_hold_angle_x10);
                return;
            }
        }
#endif

        int32_t tdoa_abs_x10 = tdbg.alpha_deg_x10;
        if (tdoa_abs_x10 < 0) tdoa_abs_x10 = -tdoa_abs_x10;
        const uint8_t tdoa_strong_ok = ((tdbg.valid != 0U) && (tdoa_abs_x10 >= TDOA_OK_MIN_ABS_X10)) ? 1U : 0U;

        if (tdoa_strong_ok != 0U) {
            if (tdoa_strong_confirm < TDOA_STRONG_CONFIRM_CYCLES) {
                tdoa_strong_confirm++;
            }
            if (tdoa_strong_confirm < TDOA_STRONG_CONFIRM_CYCLES) {
                s_auto_ctrl_src = 'T';
                return;
            }
            tdoa_lost_confirm = 0U;
            last_tdoa_ok_ms = nowm;
            s_auto_ctrl_src = 'T';
            /* Latch once, then hold for AUTO_VIEW_HOLD_MS.
             * This intentionally avoids continuous tracking jitter. */
            if (auto_hold_src != 1U) {
                auto_hold_angle_x10 = tdbg.alpha_deg_x10;
                auto_hold_src = 1U;
                auto_hold_until_ms = nowm + AUTO_VIEW_HOLD_MS;
            }
            motor_ctrl_track_pan_tdoa(nowm, auto_hold_angle_x10);
        } else if ((tdbg.valid != 0U) && ((nowm - last_tdoa_ok_ms) <= TDOA_FALLBACK_HOLD_MS)) {
            tdoa_strong_confirm = 0U;
            tdoa_lost_confirm = 0U;
            s_auto_ctrl_src = 'T';
            /* keep last tdoa-tracked position for a short hold window */
        } else if ((AUTO_USE_DETECT_FALLBACK != 0U) && mic_is_calibrated()) {
            tdoa_strong_confirm = 0U;
            if (tdoa_lost_confirm < TDOA_LOST_CONFIRM_CYCLES) {
                tdoa_lost_confirm++;
                s_auto_ctrl_src = 'T';
                return;
            }
            if (detect_active == 0U) {
                s_auto_ctrl_src = '-';
                return;
            }
            s_auto_ctrl_src = 'D';
            const uint32_t lock_until_ms = motor_ctrl_get_lock_until_ms();
            const char detect_dir = mic_process(nowm, lock_until_ms);
            motor_ctrl_process(nowm, detect_dir);
            if ((detect_dir == 'L') || (detect_dir == 'R')) {
                auto_hold_dir = detect_dir;
                auto_hold_src = 2U;
                auto_hold_until_ms = nowm + AUTO_VIEW_HOLD_MS;
            }
        } else {
            tdoa_strong_confirm = 0U;
            s_auto_ctrl_src = '-';
        }
    } else {
        prev_event_lvl = 0U;
        tdoa_strong_confirm = 0U;
        tdoa_lost_confirm = 0U;
        auto_hold_src = 0U;
        auto_hold_dir = '-';
        auto_hold_until_ms = 0U;
        s_auto_ctrl_src = 'M';
        motor_ctrl_manual_process(nowm);
    }
}

void app_sensor_loop(void)
{
    const uint32_t nowm = HAL_GetTick();

    aht10_process(nowm);
    pcf8591_process(nowm);

    static uint32_t last_dbg = 0U;
    static int8_t tdir_log_state = 0; /* -1:L, 0:C, +1:R */
    if (nowm - last_dbg >= 500U) {
        mic_debug_t dbg = {0};
        mic_tdoa_debug_t tdbg = {0};
        aht10_data_t th = {0};
        pcf8591_data_t light = {0};
        const uint16_t pan_pwm = motor_ctrl_get_pan_pwm();
        const uint16_t tilt_pwm = motor_ctrl_get_tilt_pwm();
        const int32_t pan_deg = pwm_to_deg(pan_pwm, PAN_LEFT, PAN_RIGHT);
        const int32_t tilt_deg = pwm_to_deg(tilt_pwm, TILT_UP, TILT_DOWN);
        const uint32_t i2s_drop = mic_get_i2s_seg_drop_count();
        char detect_dir = '-';
        char tdoa_dir = '-';

        if (mic_is_calibrated()) {
            mic_get_debug(&dbg);
            detect_dir = dbg.detect_dir;
        }
        mic_get_tdoa_debug(&tdbg);
        if (tdbg.valid != 0U) {
            const int32_t a = tdbg.alpha_deg_x10;
            if (tdir_log_state == 0) {
                if (a >= TDIR_ENTER_X10) tdir_log_state = 1;
                else if (a <= -TDIR_ENTER_X10) tdir_log_state = -1;
            } else if (tdir_log_state > 0) {
                if (a <= -TDIR_FLIP_X10) tdir_log_state = -1;
                else if (a < TDIR_EXIT_X10) tdir_log_state = 0;
            } else {
                if (a >= TDIR_FLIP_X10) tdir_log_state = 1;
                else if (a > -TDIR_EXIT_X10) tdir_log_state = 0;
            }
            tdoa_dir = (tdir_log_state > 0) ? 'R' : ((tdir_log_state < 0) ? 'L' : 'C');
        } else {
            tdir_log_state = 0;
        }
        aht10_get_data(&th);
        pcf8591_get_data(&light);

        const int32_t temp_abs = (th.temperature_c_x100 < 0) ? -th.temperature_c_x100 : th.temperature_c_x100;
        const char temp_sign = (th.temperature_c_x100 < 0) ? '-' : '+';

        /* RAW_A: instantaneous angle from current frame, LOC_A: filtered control angle */
        printf("I2S_L:%5lu I2S_R:%5lu | FINAL_L:%4lu FINAL_R:%4lu | DET:%c TDIR:%c VAD:%u TV:%u CONF:%u SRC:%c DROP:%lu | "
               "PAN:%3lddeg TILT:%3lddeg | RAW_A:%+ld.%01lddeg LOC_A:%+ld.%01lddeg TAU:%+ldus LAG:%+ld | "
               "T:%c%ld.%02ldC H:%lu.%02lu%% LIGHT:%3lu\r\n",
               (unsigned long)dbg.adc_avg_l, (unsigned long)dbg.adc_avg_r,
               (unsigned long)dbg.sig_l, (unsigned long)dbg.sig_r,
               detect_dir, tdoa_dir, (unsigned)tdbg.vad_pass, (unsigned)tdbg.valid, (unsigned)tdbg.confidence_q8, s_auto_ctrl_src,
               (unsigned long)i2s_drop,
               (long)pan_deg, (long)tilt_deg,
               (long)(tdbg.alpha_raw_deg_x10 / 10),
               (long)((tdbg.alpha_raw_deg_x10 < 0) ? -(tdbg.alpha_raw_deg_x10 % 10) : (tdbg.alpha_raw_deg_x10 % 10)),
               (long)(tdbg.alpha_deg_x10 / 10),
               (long)((tdbg.alpha_deg_x10 < 0) ? -(tdbg.alpha_deg_x10 % 10) : (tdbg.alpha_deg_x10 % 10)),
               (long)tdbg.tau_us,
               (long)tdbg.lag_samples,
               temp_sign,
               (long)(temp_abs / 100), (long)(temp_abs % 100),
               (unsigned long)(th.humidity_rh_x100 / 100U), (unsigned long)(th.humidity_rh_x100 % 100U),
               (unsigned long)light.light_raw);
        last_dbg = nowm;
    }
}

void app_loop(void)
{
    /* Backward-compatible wrapper (non-RTOS or legacy call path) */
    app_sensor_loop();
    app_control_loop();
}
//
