veda-Anomap/Edgedevice_stm32/(commit log)

2026-02-24 DMA 기반 코드를 위해 adc핀설정 변경 dma추가
2026-02-24 DMA 오디오 버퍼 및 초기 설정
2026-02-24 AN-35 지라 확인용 메시지
2026-02-24 AN-35 DMA 인터럽트 콜백함수 추가 및 코드 안정화
2026-02-24 AN-35 서보모터 pwm핀 타이머 원상 복구
2026-02-24 AN-35 ADC피크값 디버거 확인용출력 절대볼륨 기준 추가, 쿨다운 적용
2026-02-24 AN-35 FIFO 평균 도입SNR제어
2026-02-24 AN-35 방향조건 보수적으로 수정
    [app.c]
2026-02-24 AN-35 코드 안정화 및 로직수정
    [app.c]
2026-02-24 AN-35 마이크/모터 로직 분리 및 application연계 구조화
2026-02-24 AN-35 [stm32]다중 음향 센서 데이터 분석 로직 최적화 및 모터 세밀 제어(3채널 음향 센서 확장)
2026-02-25 AN-35 IR_LED pin ON
2026-02-25 AN-35 온습도i2c통신 핀맵 및 기본설정
2026-02-25 AN-35 온습도 센서
2026-02-25 AN-35 터미널 확인용 출력 변수 수정
    [app.c]
2026-02-25 AN-35 팬틸트(서보모터) 제어로직 추가
2026-02-25 AN-35 IR_LED 파일 분리
2026-02-25 AN-35 팬틸트 제어 보정
2026-02-25 AN-35 IR_LED 코드 안정화 , 팬틸트제어 명령어 변경
2026-02-25 AN-20 추가서보모터 핀맵 재설정 및 클럭 수정
    [irrled.ioc]
2026-02-25 AN-20 수동모드시 터미널 출력제한
2026-02-25 AN-20 uart출력설정, 팬틸트 자동모드시 원점으로 위치
2026-02-27 AN-35 온습도센서 슬라이딩 윈도우 구현
2026-02-27 AN-35 #done 확인용
2026-03-03 AN-20 마이크 좌우탐지 민감도조정
2026-03-03 readme파일 수정
2026-03-03 readme 수정2
2026-03-04 frtos 기본셋팅 및 틸트각도값 확인
2026-03-04 AN-20 rpi에서 오는 json 파싱
2026-03-04 AN-20 RTOS 기반 코드 추가 변경(halDelay-> osDelay로 변경)
2026-03-04 AN-20 dead code 수정
    [main.c]
2026-03-04 Readme, version_history수정
2026-03-05 AN-53 UART1 ISR 최소화,RTOS 큐 API 사용을 위해 include/extern 추가
2026-03-05 히스토리 수정
2026-03-05 AN-53 uartTask 컨텍스트에서 프레임 조립/처리
2026-03-05 히스토리 Task 컨텍스트에서 프레임 조립/처리, UartRxTask 실제 동작화 추가
2026-03-05 AN-53 ControlTask 전용 루프 분리, SensorTask 전용 루프 분리
2026-03-05 AN-53 dead code 정리
2026-03-05 히스토리 수정 dead code 정리,HAL timebase TIM11 분리
2026-03-05 AN-53 unauto 수신처리 추가, w/a/s/d 동작변경 자동 manual모드로 변경
2026-03-05 모터제어 코드 터미널 test용 메시지와 rpi수신용 구분으로 수정
    [app.c, main.c]
2026-03-09 조도센서
2026-03-10 모터제어 로직 수정
2026-03-12 i2s 설정 전 adc 백업완료
2026-03-12 i2s 마이크 핀맵설정
2026-03-12 adc마이크 i2s로 변경 수정
    [app.c, mic.c, mic.h]
2026-03-12 소스 오타 수정
2026-03-12 INMP441 데이터시트에 맞춰 전송 bit수정
    [app.c, irrled.ioc, main.c, mic.c, mic.h]
2026-03-12 HAL_I2S_Receive_DMA()의 Size 해석이 달라서 전달한 길이가 2배로 적용돼 DMA 버퍼 오버런이 되는 에러 수정
    [mic.c]
2026-03-12 민감도 수정
2026-03-12 mic offset에서 초기에 받는 base값 제거
2026-03-12 동적 dc보정 , 노이즈 게이트 추가
2026-03-18 rpi uart 송수신 테스크 분리
2026-03-18 파서 리싱크,처리 task 분리
2026-03-19 uart2(rpi송신 데이터)패킷 터미널 확인
2026-03-19 모터 제어 범위 수정
    [app.c, motor_ctrl.c, motor_ctrl.h]
2026-03-19 watchdog 릴레이 전원제어 기능추가
2026-03-19 stm32내부 wdg 제어 설정(iwdg)
2026-03-19 ioc변경으로 인한 핀셋팅/설정 기존코드 복구
2026-03-19 wdg 코드 검증 및 핀설정 맞춤 임계값 수정
    [main.c]
2026-03-19 변경내용 정리 및 readme수정
2026-03-20 [wdg] 테스트를 위한 로그 출력
2026-03-20 wdg 파일 분리 (main -> iwdg, realay wdg)
2026-03-20 1단계 인터페이스 추가 증상: undefined reference / 헤더-소스 시그니처 불일치 수정: mic.h 선언과 mic.c 정의를 1:1 맞춤, 빌드 우선 통과
    [mic.c, mic.h]
2026-03-20 2단계 VAD 추가 증상: 임계값 높아 감지 안 됨, 낮아 오탐 수정: 무입력/박수 로그로 기준치 재튜닝
    [app.c, mic.c]
2026-03-20 GCC-PHAT 기본 증상: lag 부호 반대(좌우 뒤집힘), NaN 발생 수정: 채널 순서 점검, PHAT 분모에 epsilon 추가
    [app.c, mic.c]
2026-03-20 confidence 게이트 증상: 반향 환경에서 valid가 계속 0 수정: peak1/peak2 임계 완화, band-pass 범위 조정
    [mic.c]
2026-03-20 app 연동 증상: 각도는 맞는데 모터가 급격히 점프 수정: alpha->PWM 매핑 범위/부호/클램프 재검증
    [app.c, motor_ctrl.c, motor_ctrl.h]
2026-03-20 EMA+deadband+hold-off 증상: 덜덜거림 또는 너무 둔함 수정: EMA alpha, deadband, hold-off 시간 튜닝
    [motor_ctrl.c]
2026-03-20 overlap 증상: 프레임 경계에서 박수 누락 수정: 50% overlap 적용, hop/frame 재설정
    [app.c, mic.c]
2026-03-20 통합 증상: UART 로그 폭주로 태스크 지연 수정: 로그 주기 제한, 디버그 레벨 분리
    [app.c, mic.c]
2026-03-23 히스토리, 상세설명 추가
2026-03-25 dma 핑퐁(half/full)버퍼 구현
2026-03-25 소리감지 틸트제어 5초 hold
2026-03-25 코드 보완 tdoa / 터미널 출력 확인코드
2026-03-25 toda 핉터 보완
2026-03-26 fallback 재활성화
2026-03-26 tdoa 필터링 보정
2026-03-27 tdoa 값 보정
